ACA-CNPEM/evolver-harware/README.md

# evolver-harware
Hardware made for the "eVOLVER versão CNPEM"
