ACA-CNPEM/evolver-harware/ADC/adc-bom.ods

Comment | Designator | Footprint | JLCPCB Part #（optional）
.1uF | C1 C10 C11 C12 C13 C14 C15 C16 C17 C18 C19 C2 C20 C21 C22 C23 C24 C3 C4 C5 C6 C7 C8 C9 | Capacitors_SMD:C_0402 | C527001 | YAGEO CC0402JRX7R6BB104
74HC4067 | IC1 | ADC:74HC_HTC4067 | -
CONNX25 | P1 P2 | mods:25_pin_10in | -
10k | R1 R12 R13 R16 R17 R20 R21 R24 R25 R28 R29 R32 R33 R36 R37 R4 R40 R41 R44 R45 R48 R49 R5 R52 R53 R56 R57 R60 R61 R64 R65 R8 R9 | Resistors_SMD:R_0402 | C25744 | UNI-ROYAL(Uniroyal Elec) 0402WGF1002TCE
1 M | R10 R14 R18 R2 R22 R26 R30 R34 R38 R42 R46 R50 R54 R58 R6 R62 | Resistors_SMD:R_0402 | C26083 | UNI-ROYAL(Uniroyal Elec) 0402WGF1004TCE
OMIT | R11 R15 R19 R23 R27 R3 R31 R35 R39 R43 R47 R51 R55 R59 R63 R7 | Resistors_SMD:R_0402
TLV1117LV33DCYR | U1 | ADC:TLV1117 | C15578 | Texas Instruments TLV1117LV33DCYR
MCP6001 | U2 | ADC:MCP6001 | C116490 | Microchip Tech MCP6001T-I/OT
MCP6004 | U3 U4 U5 U6 | ADC:MCP6004 | C50282 | Microchip Tech MCP6004T-I/ST
