ACA-CNPEM/evolver-harware/Auxiliary/aux-bom.xlsx

Comment | Designator | Footprint | JLCPCB Part #（optional）
10 uF | C1 | mods:FK18X5R0J105K
10uF | C2 C3 | mods:FK18X5R0J105K
Heatsink | HS1 | mods:CSM222-30AE
CONN_01X02 | J1 | mods:OSTYK51102030
DNP | J2 | mods:OSTYK51102030
DNP | J3 | mods:2.1mm_DC_Jack
FAN | J4 | mods:OSTYK51102030
CONN_02X25 | M1 M2 M3 | mods:50_pin_10in
CONN_02X09 | M4 | mods:2x_9_pin_10in
MountingHole | MH1 MH2 MH3 MH4 MH5 MH6 | mods:mh_632
CONN_02X08 | P1 P2 P3 P4 P5 P6 | mods:2x8_conn_10in
RJ14 | P7 P8 | mods:RJ14
CONN_01X10 | GND_M1 GND_M2 GND_M3 PWR_M1 PWR_M2 PWR_M3 | mods:10pin_tenth_in
50k | R1 | mods:R_0.25W
10k | R2 | mods:R_0.25W
CONN_02X12 | U1 | mods:24_pin_10in
MC7805 | U2 | mods:TO-220
