ACA-CNPEM/evolver-harware/CMB/cmb-bom.ods

Comment | Designator | Footprint | JLCPCB Part #（optional）
CONN_02X08 | P1 | mods:2x8_pin_10in | -
CONN_01X04 | P2 | mods:4_ScrewTerm | C918122 | DIBO DB125-2.54-4P-GN-S
DNP (Thermistor) | P5 | mods:Thermistor | - | 103 jt-025 / semitec
IR LED | P6 | mods:screw_terminal | C557685 | Ningbo Xinlaiya Elec. XY308-2.54-2P
IR Detector | P7 | mods:screw_terminal | C557685 | Ningbo Xinlaiya Elec. XY308-2.54-2P
Spare B | P8 | mods:screw_terminal | C557685 | Ningbo Xinlaiya Elec. XY308-2.54-2P
Spare A | P9 | mods:screw_terminal | C557685 | Ningbo Xinlaiya Elec. XY308-2.54-2P
82 | R1 R3 R4 R7 | mods:Through_hole_R | C265588 | Thunder Component MELF-MFR02041/4WS82ΩFT50
Heater 1 | R5 | mods:Heater | - | Mp915-20.0-1% / Caddock
Heater 2 | R6 | mods:Heater | - | Mp915-20.0-1% / Caddock
