ACA-CNPEM/evolver-harware/CMB/cmb-bom.xlsx

Comment | Designator | Footprint | JLCPCB Part #（optional）
CONN_02X08 | P1 | mods:2x8_pin_10in | C16133
CONN_01X04 | P2 | mods:4_ScrewTerm | C22809
DNP (Thermistor) | P5 | mods:Thermistor | C136744
IR LED | P6 | mods:screw_terminal | C27438
IR Detector | P7 | mods:screw_terminal | C110153
Spare B | P8 | mods:screw_terminal | C33901
Spare A | P9 | mods:screw_terminal | C114097
82 | R1 R3 R4 R7 | mods:Through_hole_R
Heater 1 | R5 | mods:Heater
Heater 2 | R6 | mods:Heater
