ACA-CNPEM/evolver-harware/CMB/SmartSleeve_Parts.xlsx

Description | Part # | Vendor | Purpose
Heating Resistors | 684-MP915-20 | Mouser | Turns current into heat for temperature control.
Thermistor | 954-103JT-025 | Mouser | Resistor that changes value based on temperature
IR LED | 475-2943-ND | Digikey | Optical density measurements.
IR Photodiode | 160-1987-ND | Digikey | Optical density measurements.
12V Computer Fan | Q619-ND | Digikey | Computer Fan to Mount Magnets
