ACA-CNPEM/evolver-harware/Motherboard/mb-bom.xlsx

Comment | Designator | Footprint
1uF | C1 C10 C11 C12 C13 C14 C19 C2 C20 C3 C4 C5 C6 C7 C8 C9 | mods:FK18X5R0J105K
10 uF | C15 C16 C17 C18 | mods:FK18X5R0J105K
CONN_01X10 | GND_M1 GND_M2 GND_M3 GND_M4 GND_M5 GND_M6 GND_M7 GND_M8 PWR_M1 PWR_M2 PWR_M3 PWR_M4 PWR_M5 PWR_M6 PWR_M7 PWR_M8 | mods:10_pin_10in
SCREW_TERM | J1 | mods:OSTYK51104030
USB_A | J3 J6 | mods:USB-A
CONN_02X03 | J4 | mods:2x3_pin_10in
DNP | J2 J5 | mods:USB-A_vert
RJ14 | J7 | mods:609-1064-ND
RJ14 | J8 | mods:609-5080-ND
JUMPER3 | JP1 JP2 JP3 JP4 JP5 JP6 JP7 JP8 | mods:Pin_Header_Straight_1x03_Pitch5.08mm
CONN_02X25 | M1 M2 M3 M4 M5 M6 M7 M8 | mods:50_pin_10in
CONN_02X09 | M9 | mods:RS485
MountingHole | MH1 MH10 MH11 MH12 MH13 MH14 MH15 MH16 MH2 MH3 MH4 MH5 MH6 MH7 MH8 MH9 | mods:mh_632
CONN_02X08 | P1 P10 P11 P12 P13 P14 P15 P16 P2 P3 P4 P5 P6 P7 P8 P9 | mods:2x8_pin_10in
CONN_01X02 | P31 | mods:2_pin_10in
Jumper_Receptacle | P38 P39 P40 P41 P42 P43 P44 P45 P46 P47 P48 P49 P50 P51 P52 P53 P54 P55 P56 P57 P58 P59 P60 P61
20k | R1 | mods:R_200mil
10k | R2 R3 R4 R5 | mods:R_200mil
9_R_01X10 | RP1 RP10 RP11 RP12 RP13 RP14 RP15 RP16 RP2 RP3 RP4 RP5 RP6 RP7 RP8 RP9 | mods:10_pin_10in
via_stitch | TP1 TP10 TP11 TP12 TP13 TP14 TP15 TP16 TP17 TP18 TP19 TP2 TP20 TP21 TP22 TP23 TP24 TP3 TP4 TP5 TP6 TP7 TP8 TP9 | mods:stitch_via
CONN_02X12 | U1 U2 U3 U4 | mods:24_pin_10in
