ACA-CNPEM/evolver-harware/Pi-HAT/pi-hat-bom.ods

Comment | Designator | Footprint | JLCPCB Part #
1uF | C1 C2 C3 | project_footprints:C_0805_HS | C89259 | FH (Guangdong Fenghua Adva
LED | D1 D2 | project_footprints:LED_0603 | C497926 | HONGLITRONIC(Hongli Zhihui
raspberrypi_hat:OX40HAT | J1 | project_footprints:Connector_PinSocket_2.54mm | BCEF2 (Filipeflop) | https://www.makerhero.com/produto/barra-de-pinos-2x20-macho-femea/
Header_10Pin | J2 | project_footprints:10Pin_Header | -
Header_8Pin | J3 J4 J5 | project_footprints:8Pin_Header | -
RJ14 | J6 | project_footprints:609-5080-ND
2Screw_Term | J7 | project_footprints:277-1667-ND | C784572 | DEGSON DG125-5.0-02P-14-00A(H)
2N7002 | Q3 Q4 | project_footprints:2N7002 | C8545 | Jiangsu Changjing Electronics
BSS123 | Q5 | project_footprints:2N7002 | C79015 | Jiangsu Changjing Electronic
510 | R1 R2 | project_footprints:R_805_HS | C228886 | YAGEO AC0805FR-07510RL
DNP | R3 R6 | project_footprints:R_805_HS | C17414 | UNI-ROYAL(Uniroyal Elec) 080
10k | R10 R12 R4 R5 | project_footprints:R_805_HS | C17414 | UNI-ROYAL(Uniroyal Elec) 080
MAX3485 | U1 | project_footprints:SO-8
