ACA-CNPEM/evolver-harware/Pi-HAT/pi-hat-bom.xlsx

Comment | Designator | Footprint | JLCPCB Part #（optional）
1uF | C1 C2 C3 | project_footprints:C_0805_HS
LED | D1 D2 | project_footprints:LED_0603
raspberrypi_hat:OX40HAT | J1 | project_footprints:Connector_PinSocket_2.54mm
Header_10Pin | J2 | project_footprints:10Pin_Header
Header_8Pin | J3 J4 J5 | project_footprints:8Pin_Header
RJ14 | J6 | project_footprints:609-5080-ND
2Screw_Term | J7 | project_footprints:277-1667-ND
2N7002 | Q3 Q4 | project_footprints:2N7002
BSS123 | Q5 | project_footprints:2N7002
510 | R1 R2 | project_footprints:R_805_HS
DNP | R3 R6 | project_footprints:R_805_HS
10k | R10 R12 R4 R5 | project_footprints:R_805_HS
MAX3485 | U1 | project_footprints:SO-8
