ACA-CNPEM/evolver-harware/RS485/rs485-bom.xlsx

Comment | Designator | Footprint | JLCPCB Part #（optional）
.1uF | C1 C2 C3 | mods:C_0402
10nF | C4 | mods:C_0402
1nF | C5 | mods:C_0402
100pF | C6 | mods:C_0402
10pF | C7 | mods:C_0402
CONN_01X09 | P1 P2 | mods:9_pin_10in
10k | R1 R2 R3 R4 | mods:R_0402
SP3485CN | U1 U2 U4 U5 | mods:SO-8
TLV1117LV33DCYR | U3 | mods:TLV1117LV33DCYR
