ACA-CNPEM/evolver-harware/PWM/pwm-bom.xlsx

Comment | Designator | Footprint | JLCPCB Part #（optional）
0.1uF | C1 C10 C2 C5 C6 C7 C8 C9 | mods:C_0402
1uF | C3 C4 | mods:C_0402
ZHCS506TA | D1 D10 D11 D12 D13 D14 D15 D16 D2 D3 D4 D5 D6 D7 D8 D9 | mods:ZHCS506TA
CONN_01X25_1 | P1 P2 | mods:25_pin_10in
CONN_01X10 | P3 P4 | mods:10pin_tenth_in
AO3422 | Q1 Q10 Q11 Q12 Q13 Q14 Q15 Q16 Q2 Q3 Q4 Q5 Q6 Q7 Q8 Q9 | mods:AO3422
10K | R1 R10 R11 R12 R13 R14 R15 R16 R2 R3 R4 R5 R6 R7 R8 R9 R18 | mods:R_0402
2.2k | R17 | mods:R_0402
TLV1117LV33DCYR | U1 | mods:TLV1117LV33DCYR
TLC5940PWP | U2 | mods:TLC5940PWP
