ACA-CNPEM/evolver-harware/RS485/rs485-bom.ods

Comment | Designator | Footprint | JLCPCB Part #（optional）
.1uF | C1 C2 C3 | mods:C_0402 | C110251 | FH (Guangdong Fenghua Advanced Tech) 0402B104K500NT
10nF | C4 | mods:C_0402 | C1524 | FH (Guangdong Fenghua Advanced Tech) 0402B103K500NT
1nF | C5 | mods:C_0402 | C335530 | Walsin Tech Corp 0402B102K250CT
100pF | C6 | mods:C_0402 | C1546 | FH (Guangdong Fenghua Advanced Tech) 0402CG101J500NT
10pF | C7 | mods:C_0402 | C295953 | Walsin Tech Corp 0402N100D500CT
CONN_01X09 | P1 P2 | mods:9_pin_10in | -
10k | R1 R2 R3 R4 | mods:R_0402 | C269674 | TyoHM RMC040210KFN
SP3485CN | U1 U2 U4 U5 | mods:SO-8 | -
TLV1117LV33DCYR | U3 | mods:TLV1117LV33DCYR | C15578 | Texas Instruments TLV1117LV33DCYR
