ACA-CNPEM/evolver-harware/Schematics PDF/Motherboard.pdf

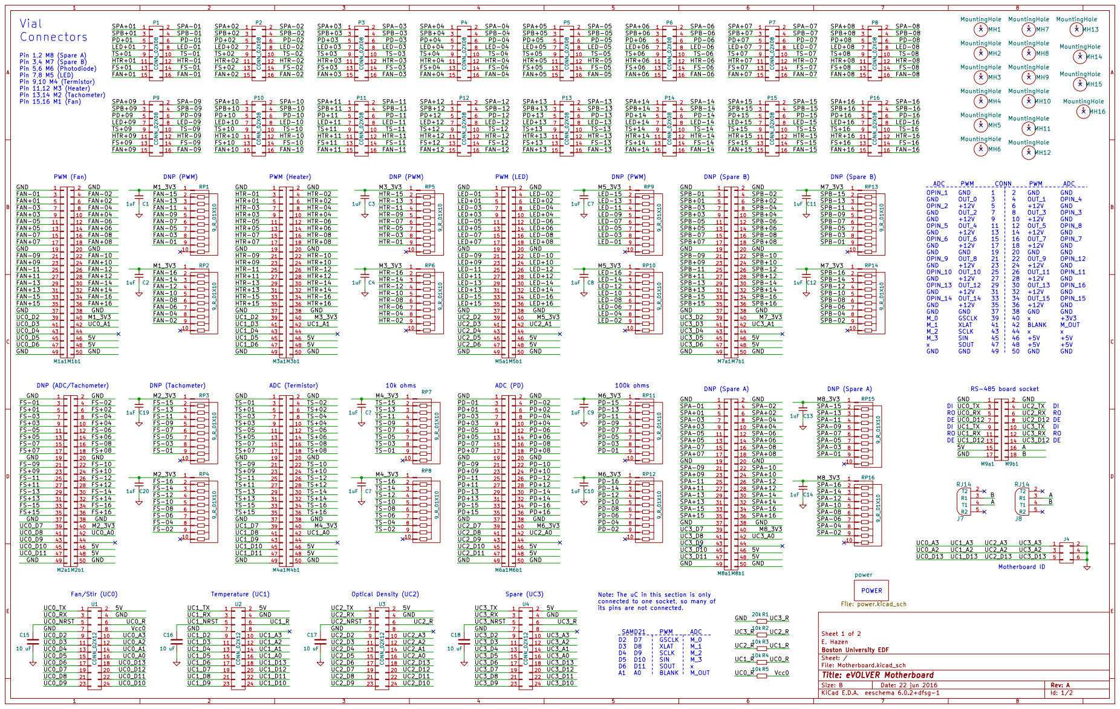
[picture p1: page 1]

FS+02 FAN+02 SPA+02 PD+02 SPB+02

SPA-07
LED+08 FS+16 PD+16 FAN+16 SPB+16

LED+01
TS+02 HTR+02 FS-09 FAN-09 PD+09

LED-02 FAN-02 HTR-02 FS-02

LED+15 FAN-05 HTR-05 FS-05

Pin 1,2 M8 (Spare A)
SPA-09 FAN-01 FS+01 HTR+01 FAN+01 FAN+09 GND
Pin 3,4 M7 (Spare B)
Pin 5,6 M6 (Photodiode)
Pin 7,8 M5 (LED)
Pin 9,10 M4 (Termistor)
Pin 11,12 M3 (Heater)
Pin 13,14 M2 (Tachometer)

FS+04 HTR-02 HTR+02 GND

LED+13 FAN+05 HTR-13 FAN-04 GND

LED+10 SPB-09
LED-09 HTR-09 PD-09 TS-09

LED+11 SPA+11 PD+11 SPB+11

LED-13 SPA-13 PD-13 SPB-13

FAN+09 FAN-01 FAN+01 FAN-15 FAN+11 FAN-13 FAN+13 FAN+05 FAN+07 GND

HTR+16 HTR-16 HTR+14 HTR-06 HTR+06 HTR-04 FS-16

UC1_D5 HTR-15 HTR+15 HTR+13 GND

Note: The uC in this section is only
connected to one socket, so many of
its pins are not connected.

Id: 1/2 Title: eVOLVER Motherboard

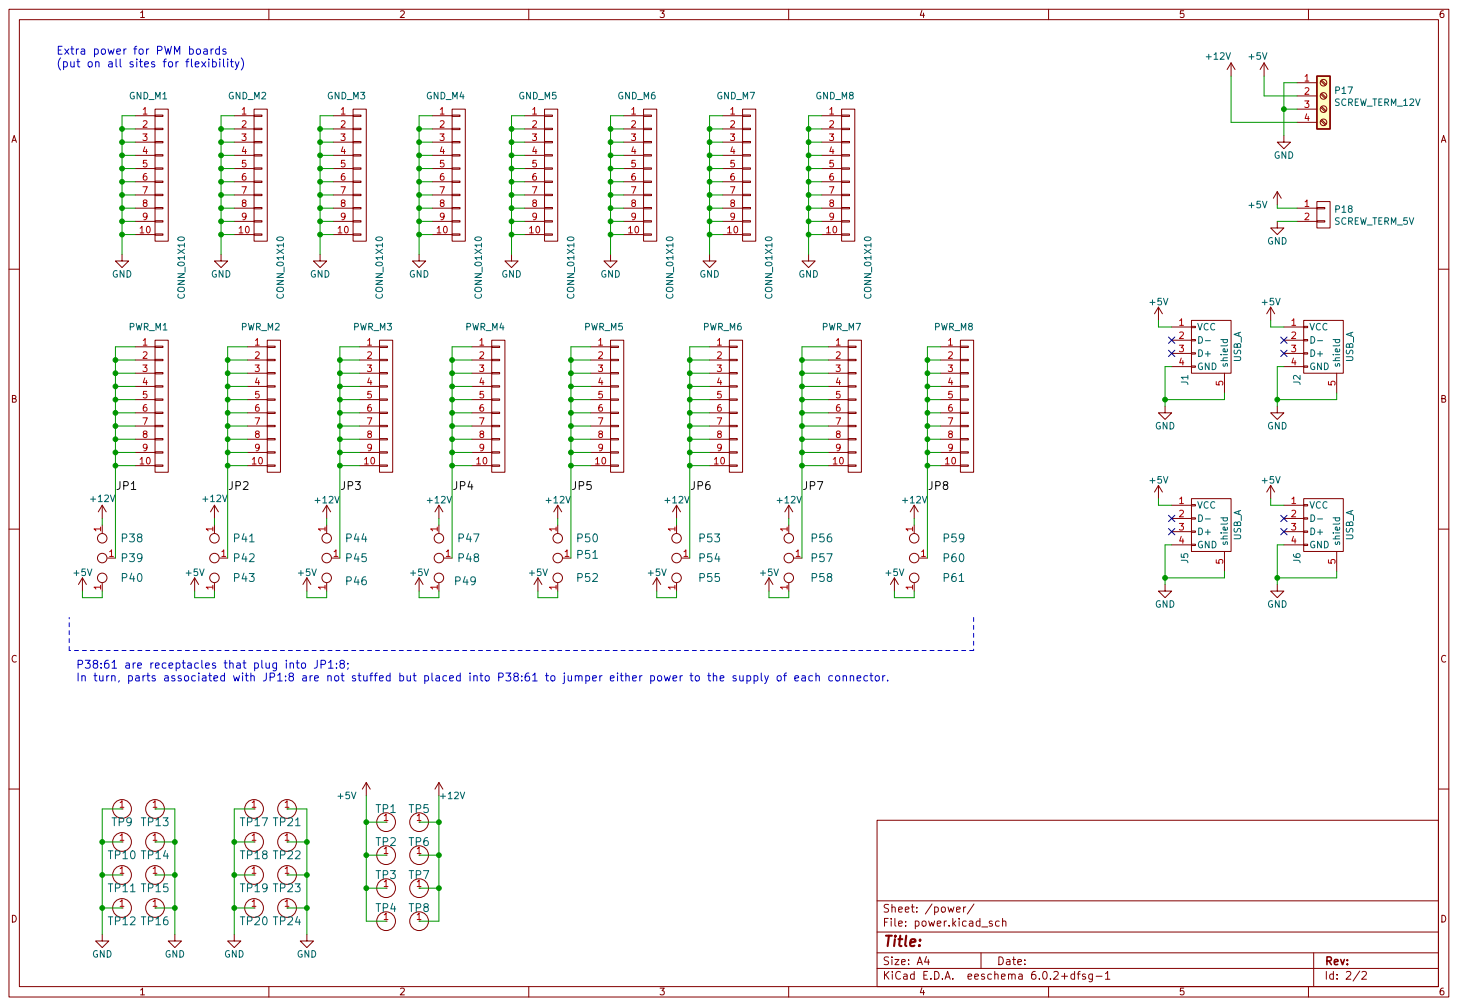
[picture p2: page 2]

P38:61 are receptacles that plug into JP1:8;
In turn, parts associated with JP1:8 are not stuffed but placed into P38:61 to jumper either power to the supply of each connector.
