ACA-CNPEM/evolver-harware/Schematics PDF/Auxiliary_Board.pdf

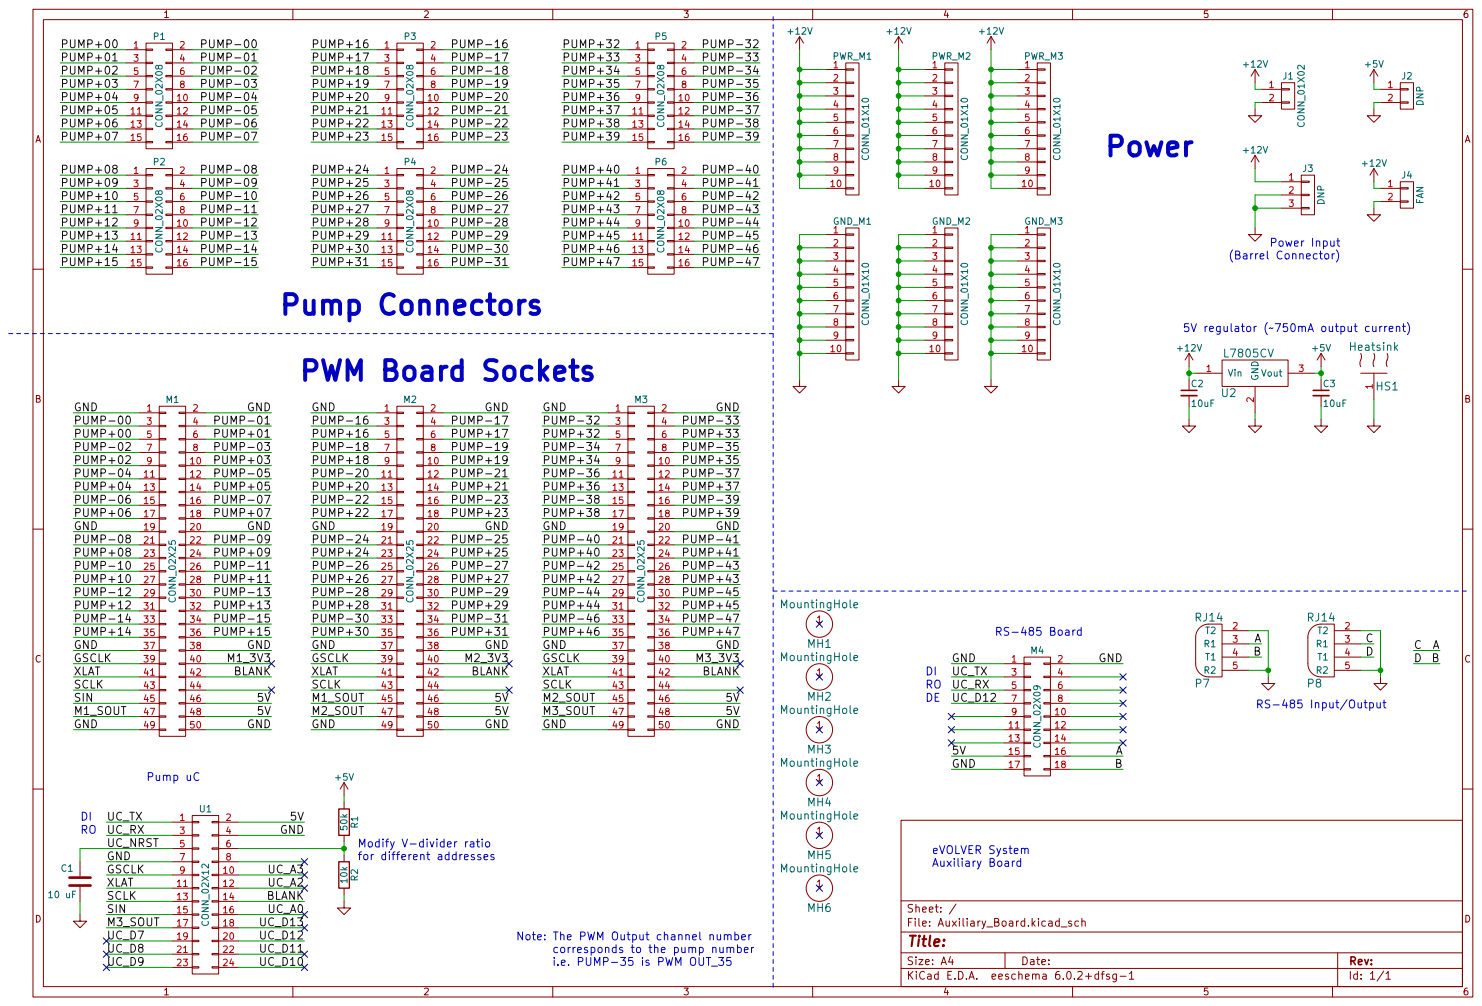
[picture p3: page 1]

PUMP-43 PUMP+17 PUMP-17 PUMP-19 UC_D9
PUMP-44 SCLK

PUMP-25 PUMP+25 PUMP-27 PUMP+23 GSCLK

PUMP+44 PUMP-44 PUMP+27 PUMP-29

for different addresses RO

corresponds to the pump number
i.e. PUMP-35 is PWM OUT_35
