ACA-CNPEM/evolver-harware/Schematics PDF/CMB.pdf

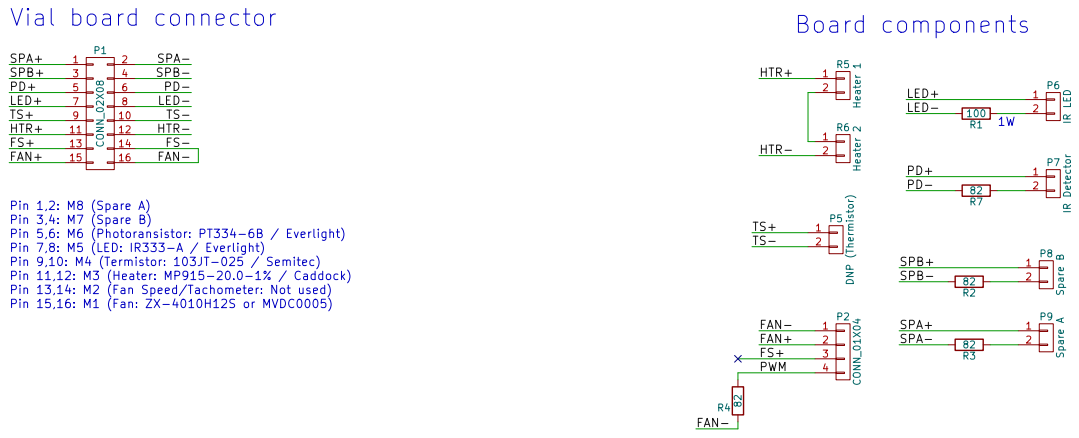
[picture p4: page 1]

LED+ TS+ PD+ Pin 11,12: M3 (Heater: MP915-20.0-1% / Caddock)

11 | 12
13 | 14

Pin 13,14: M2 (Fan Speed/Tachometer: Not used)
Pin 15,16: M1 (Fan: ZX-4010H12S or MVDC0005)
