ACA-CNPEM/evolver-harware/Schematics PDF/Pi-Hat.pdf

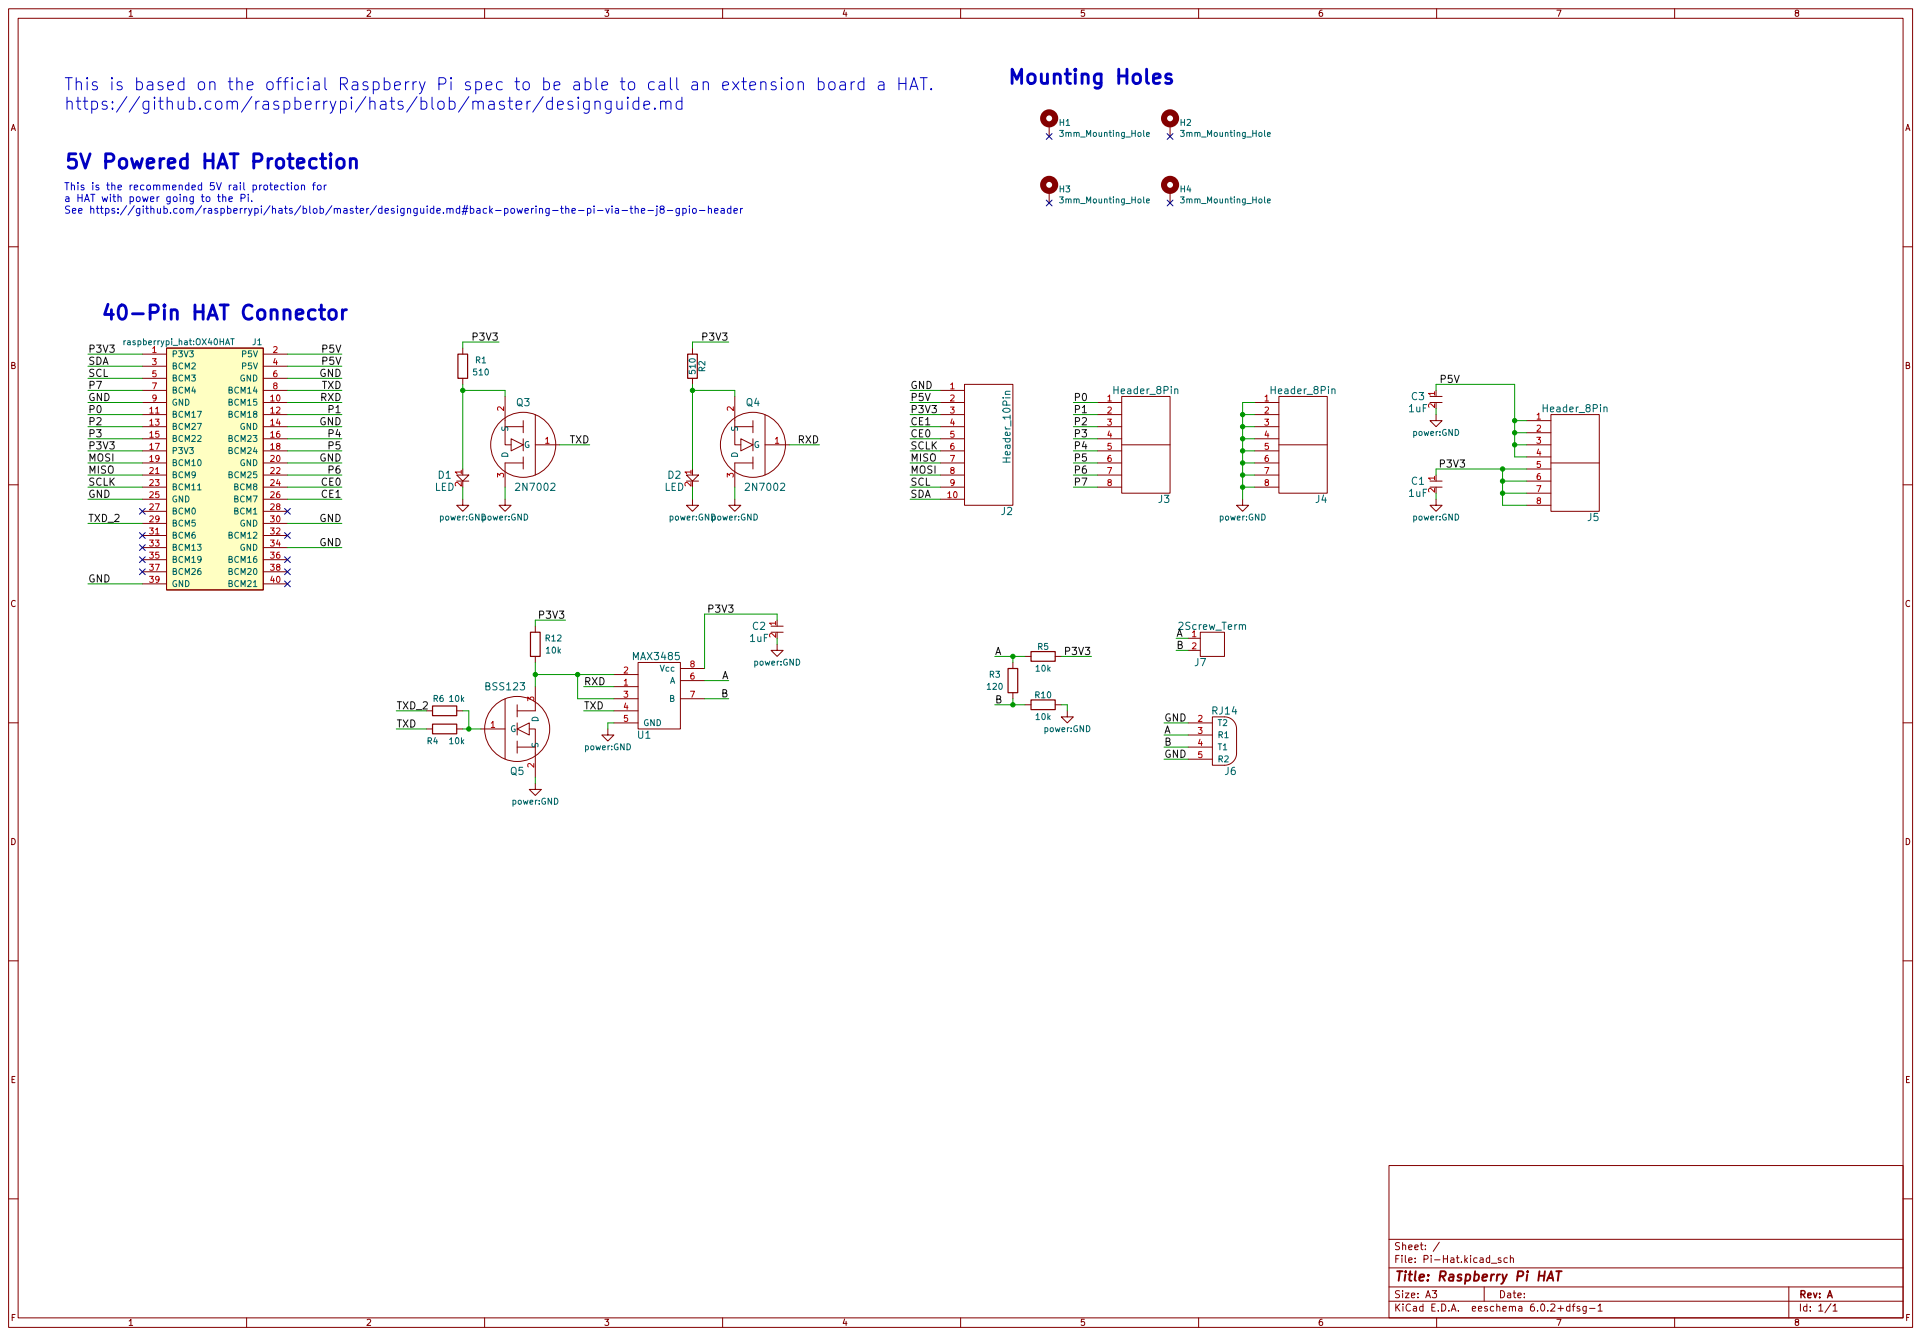
[picture p5: page 1]

This is based on the official Raspberry Pi spec to be able to call an extension board a HAT.
https://github.com/raspberrypi/hats/blob/master/designguide.md

This is the recommended 5V rail protection for
a HAT with power going to the Pi.
See https://github.com/raspberrypi/hats/blob/master/designguide.md#back-powering-the-pi-via-the-j8-gpio-header

File: Pi-Hat.kicad_sch Sheet: /
Id: 1/1 Title: Raspberry Pi HAT
