ACA-CNPEM/evolver-harware/Schematics PDF/RS485.pdf

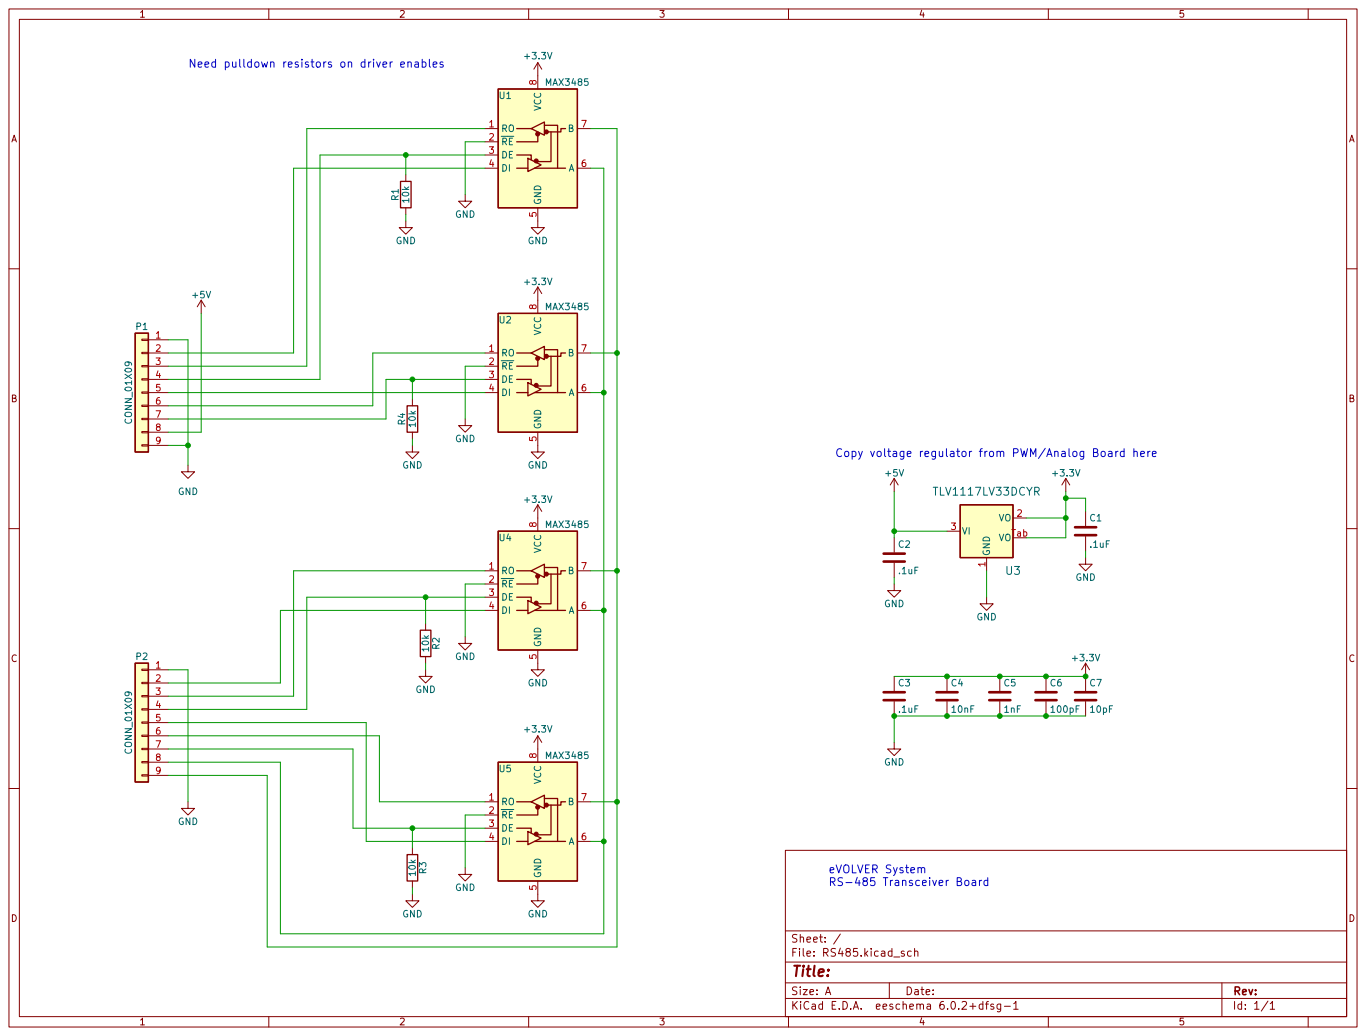
[picture p6: page 1]

Need pulldown resistors on driver enables

Copy voltage regulator from PWM/Analog Board here
