ACA-CNPEM/evolver-harware/Schematics PDF/ADC.pdf

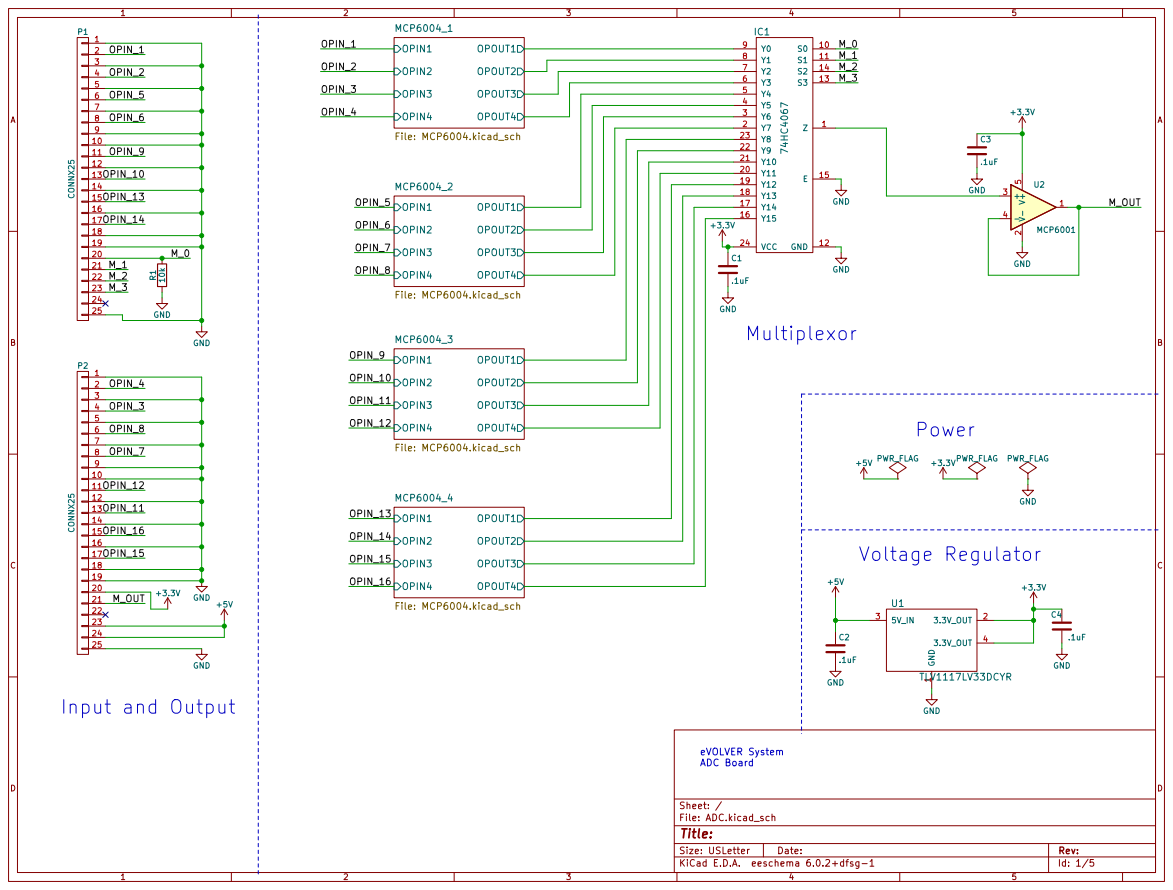
[picture p7: page 1]

253456789 P1 CONNX25

OPIN_5

OPIN_6

17 OPIN_14

10
OPIN_12 11

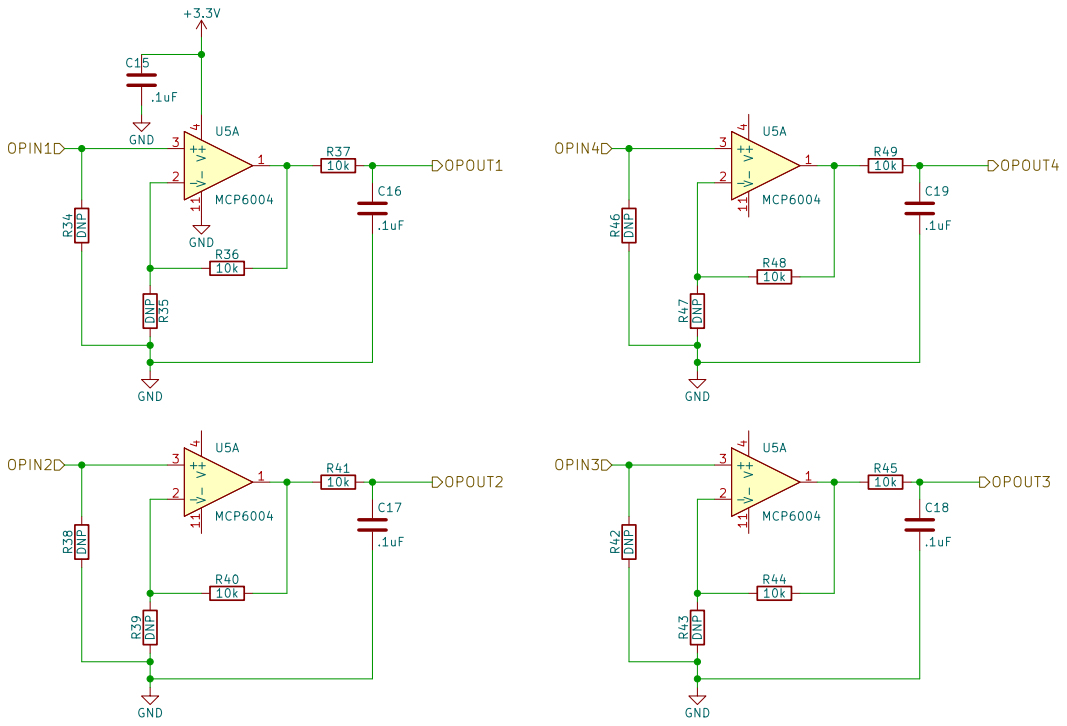
[picture p8: page 2]
