ACA-CNPEM/evolver-harware/Schematics PDF/PWM.pdf

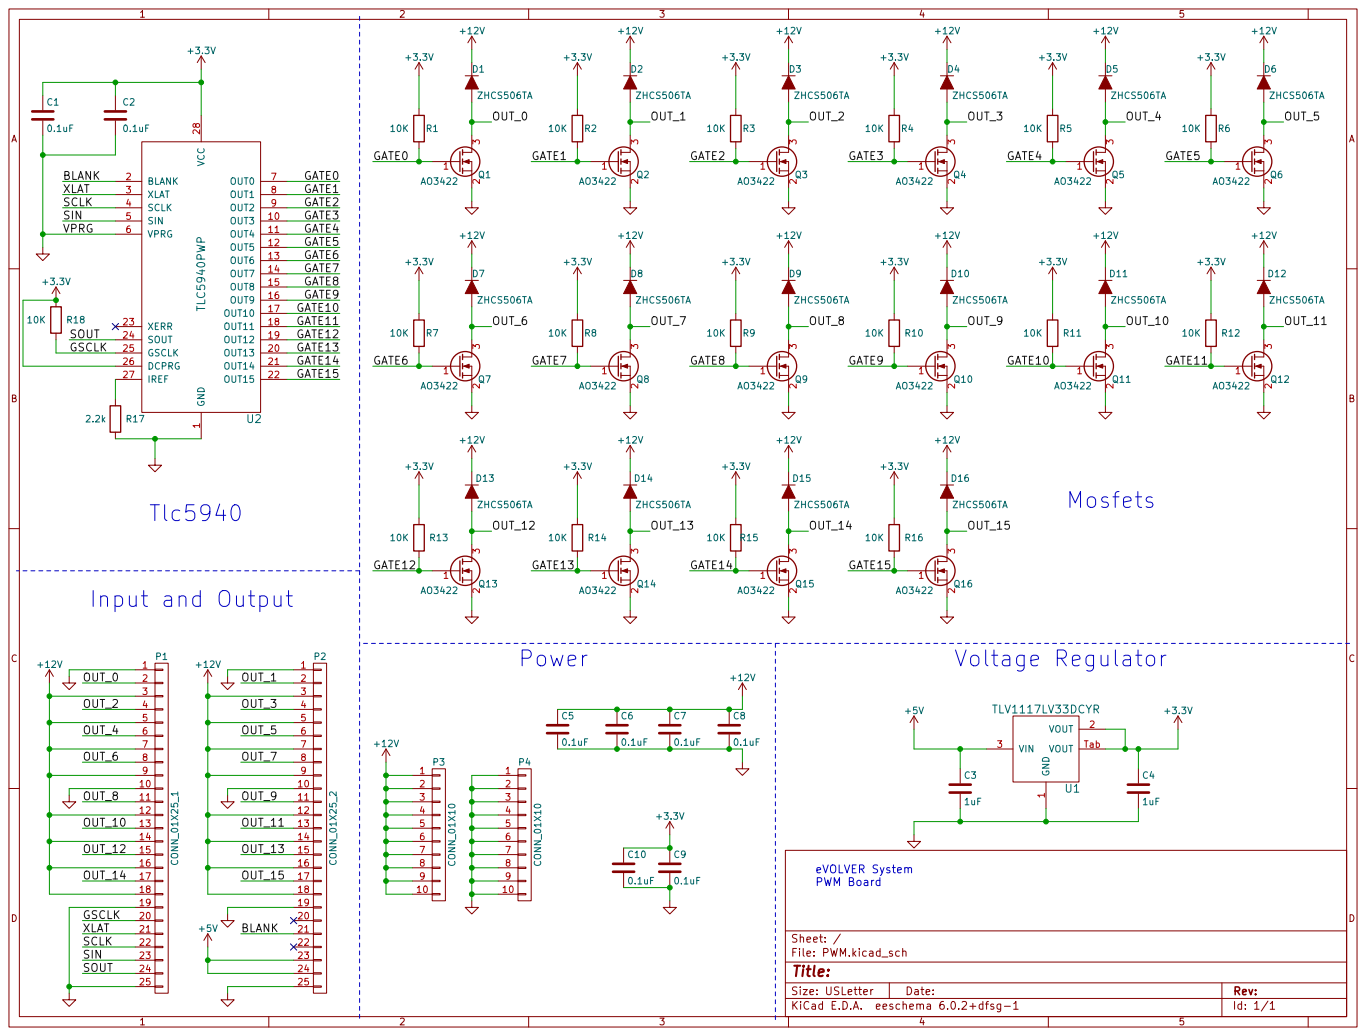
[picture p9: page 1]

1 OUT3 10 OUT4 11 OUT5 12 OUT6 13 OUT7 14 OUT8 15 OUT9 16 OUT10 17 OUT11 18 OUT12 19 BLANK 2 OUT13 20 OUT14 21 OUT15 22 XERR 23 SOUT 24 GSCLK 25 DCPRG 26

1 VOUT 2 VIN 3 VOUT Tab U1 TLV1117LV33DCYR

GSCLK | 20 | 20
