ACA-CNPEM/evolver-harware/(list of files, drawings)

Other design files:
Auxiliary/Fabricação/Auxiliary.dsn
