ACA-CNPEM/evolver-harware/ADC/Projeto/ADC.kicad_sch

## KiCad design ADC/Projeto/ADC.kicad_sch (2023-03-21)

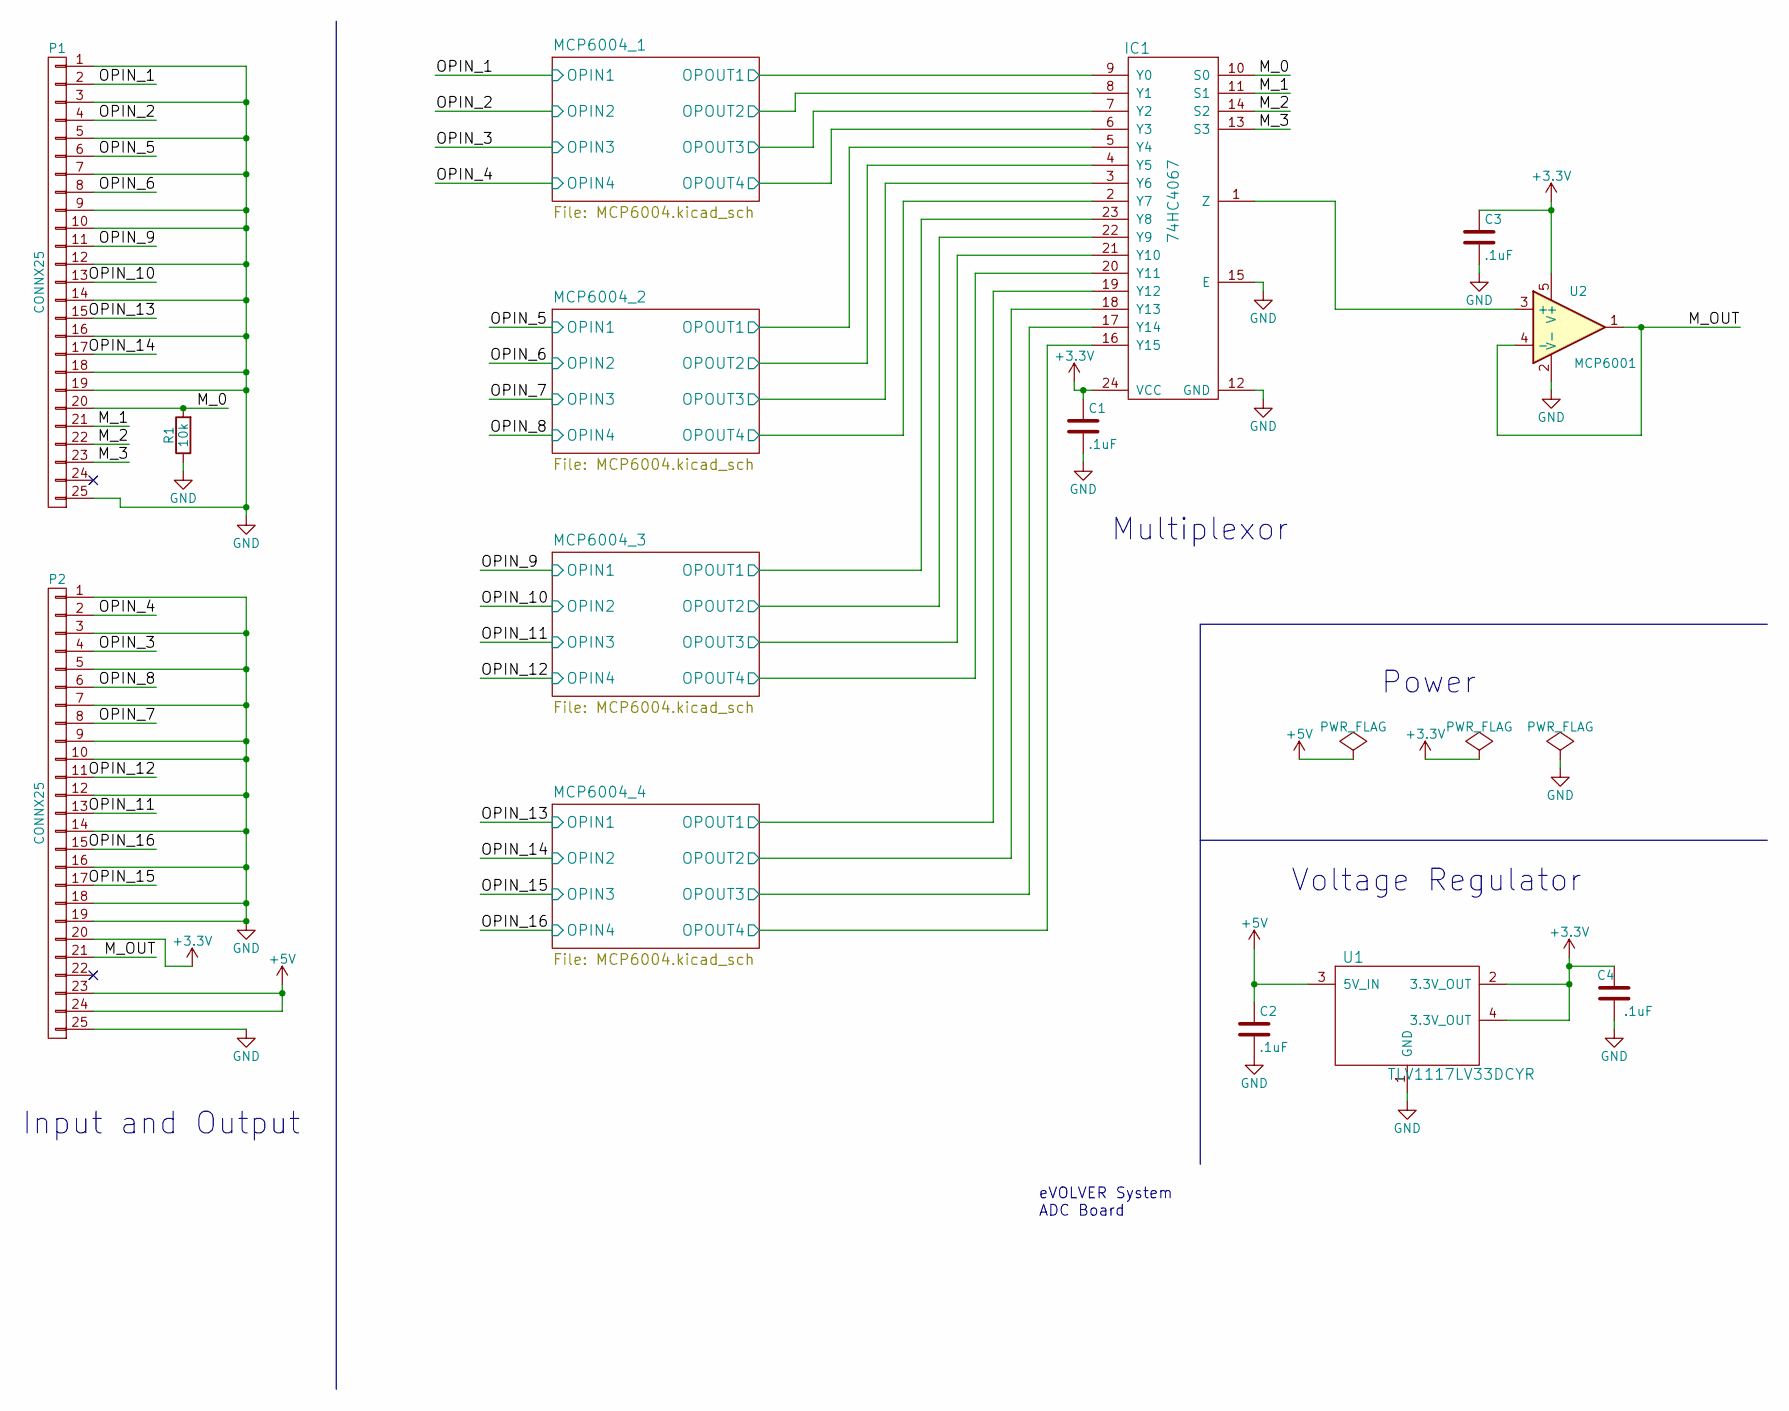
[picture p10: schematic ADC.kicad_sch]

Parts:
C1, C2, C3, C4: .1uF; C_0402
IC1: 74HC4067; 74HC_HTC4067
P1, P2: CONNX25; 25_pin_10in
R1: 10k; R_0402
U1: TLV1117LV33DCYR; TLV1117
U2: MCP6001

Connections:
+3.3V: C1.1, C3.1, C4.1, IC1.24 (VCC), P2.20, U1.2 (3.3V_OUT), U1.4 (3.3V_OUT), U2.5 (V+)
+5V: C2.1, P2.23, P2.24, U1.3 (5V_IN)
GND: C1.2, C2.2, C3.2, C4.2, IC1.12 (GND), IC1.15 (E), P1.1, P1.3, P1.5, P1.7, P1.9, P1.10, P1.12, P1.14, P1.16, P1.18, P1.19, P1.25, P2.1, P2.3, P2.5, P2.7, P2.9, P2.10, P2.12, P2.14, P2.16, P2.18, P2.19, P2.25, R1.1, U1.1 (GND), U2.2 (V-)
M_0: IC1.10 (S0), P1.20, R1.2
M_1: IC1.11 (S1), P1.21
M_2: IC1.14 (S2), P1.22
M_3: IC1.13 (S3), P1.23
M_OUT: P2.21, U2.1, U2.4 (-)
unnamed: IC1.1 (Z), U2.3 (+)
OPIN_1: P1.2
OPIN_2: P1.4
OPIN_3: P2.4
OPIN_4: P2.2
OPIN_5: P1.6
OPIN_6: P1.8
OPIN_7: P2.8
OPIN_8: P2.6
OPIN_9: P1.11
OPIN_10: P1.13
OPIN_11: P2.13
OPIN_12: P2.11
OPIN_13: P1.15
OPIN_14: P1.17
OPIN_15: P2.17
OPIN_16: P2.15
OPOUT1: IC1.5 (Y4), IC1.9 (Y0), IC1.19 (Y12), IC1.23 (Y8)
OPOUT2: IC1.4 (Y5), IC1.8 (Y1), IC1.18 (Y13), IC1.22 (Y9)
OPOUT3: IC1.3 (Y6), IC1.7 (Y2), IC1.17 (Y14), IC1.21 (Y10)
OPOUT4: IC1.2 (Y7), IC1.6 (Y3), IC1.16 (Y15), IC1.20 (Y11)

Notes on the sheet:
eVOLVER System ADC Board
Input and Output
Multiplexor
Voltage Regulator
Power
