ACA-CNPEM/evolver-harware/ADC/Projeto/MCP6004.kicad_sch

## KiCad design ADC/Projeto/MCP6004.kicad_sch (2023-03-21)

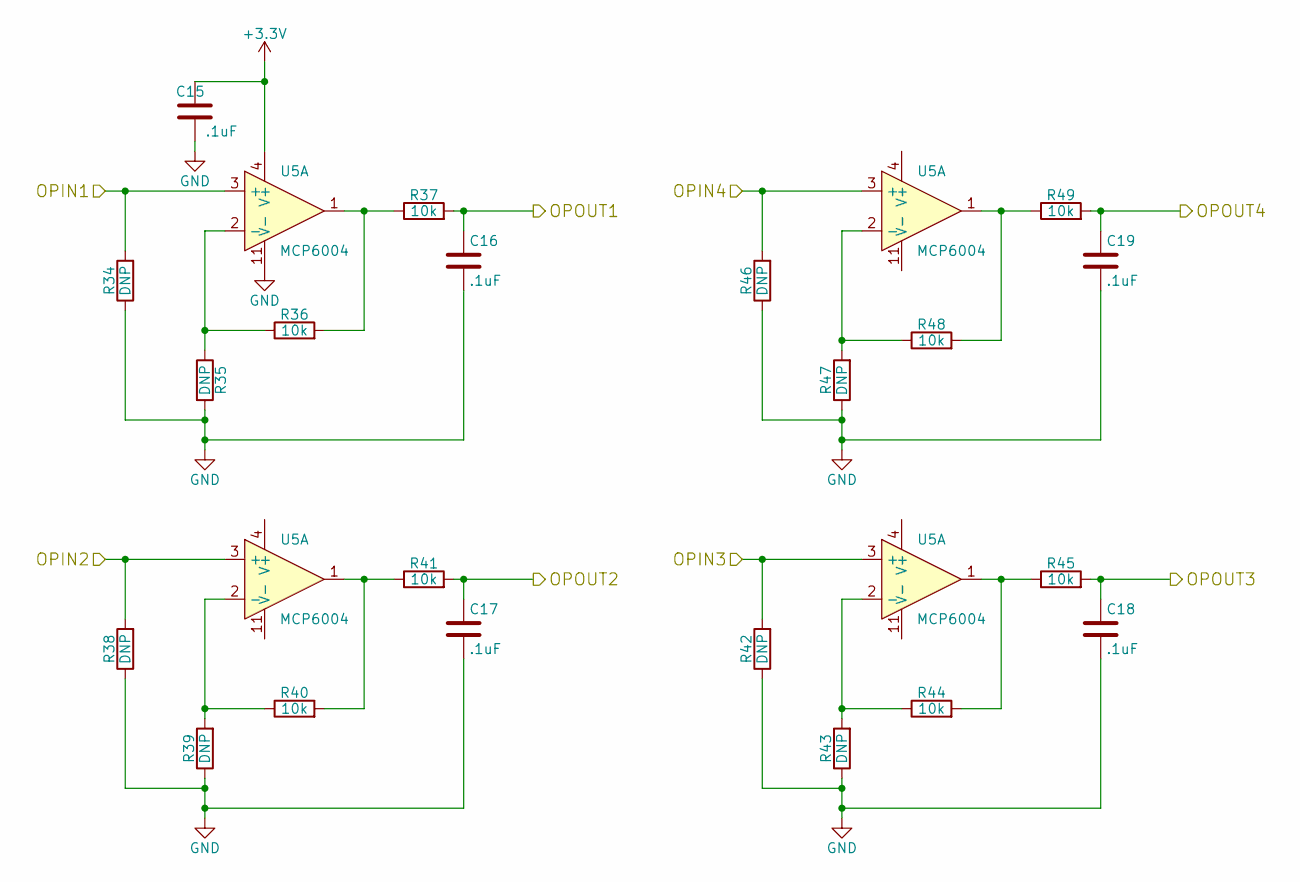
[picture p11: schematic MCP6004.kicad_sch]

Parts:
C15, C16, C17, C18, C19: .1uF; C_0402
R34, R35, R38, R39, R42, R43, R46, R47: DNP; R_0402
R36, R37, R40, R41, R44, R45, R48, R49: 10k; R_0402
U5: MCP6004

Connections:
+3.3V: C15.1, U5.4 (V+)
GND: C15.2, C16.2, C17.2, C18.2, C19.2, R34.1, R35.2, R38.1, R39.1, R42.1, R43.1, R46.1, R47.1, U5.11 (V-)
unnamed: R35.1, R36.1, U5.2 (-)
unnamed: R36.2, R37.1, U5.1
unnamed: R39.2, R40.1, U5.2 (-)
unnamed: R40.2, R41.1, U5.1
unnamed: R43.2, R44.1, U5.2 (-)
unnamed: R44.2, R45.1, U5.1
unnamed: R47.2, R48.1, U5.2 (-)
unnamed: R48.2, R49.1, U5.1
OPIN1: R34.2, U5.3 (+)
OPIN2: R38.2, U5.3 (+)
OPIN3: R42.2, U5.3 (+)
OPIN4: R46.2, U5.3 (+)
OPOUT1: C16.1, R37.2
OPOUT2: C17.1, R41.2
OPOUT3: C18.1, R45.2
OPOUT4: C19.1, R49.2
