ACA-CNPEM/evolver-harware/CMB/Projeto/CMB.kicad_sch

## KiCad design CMB/Projeto/CMB.kicad_sch (2023-03-21)

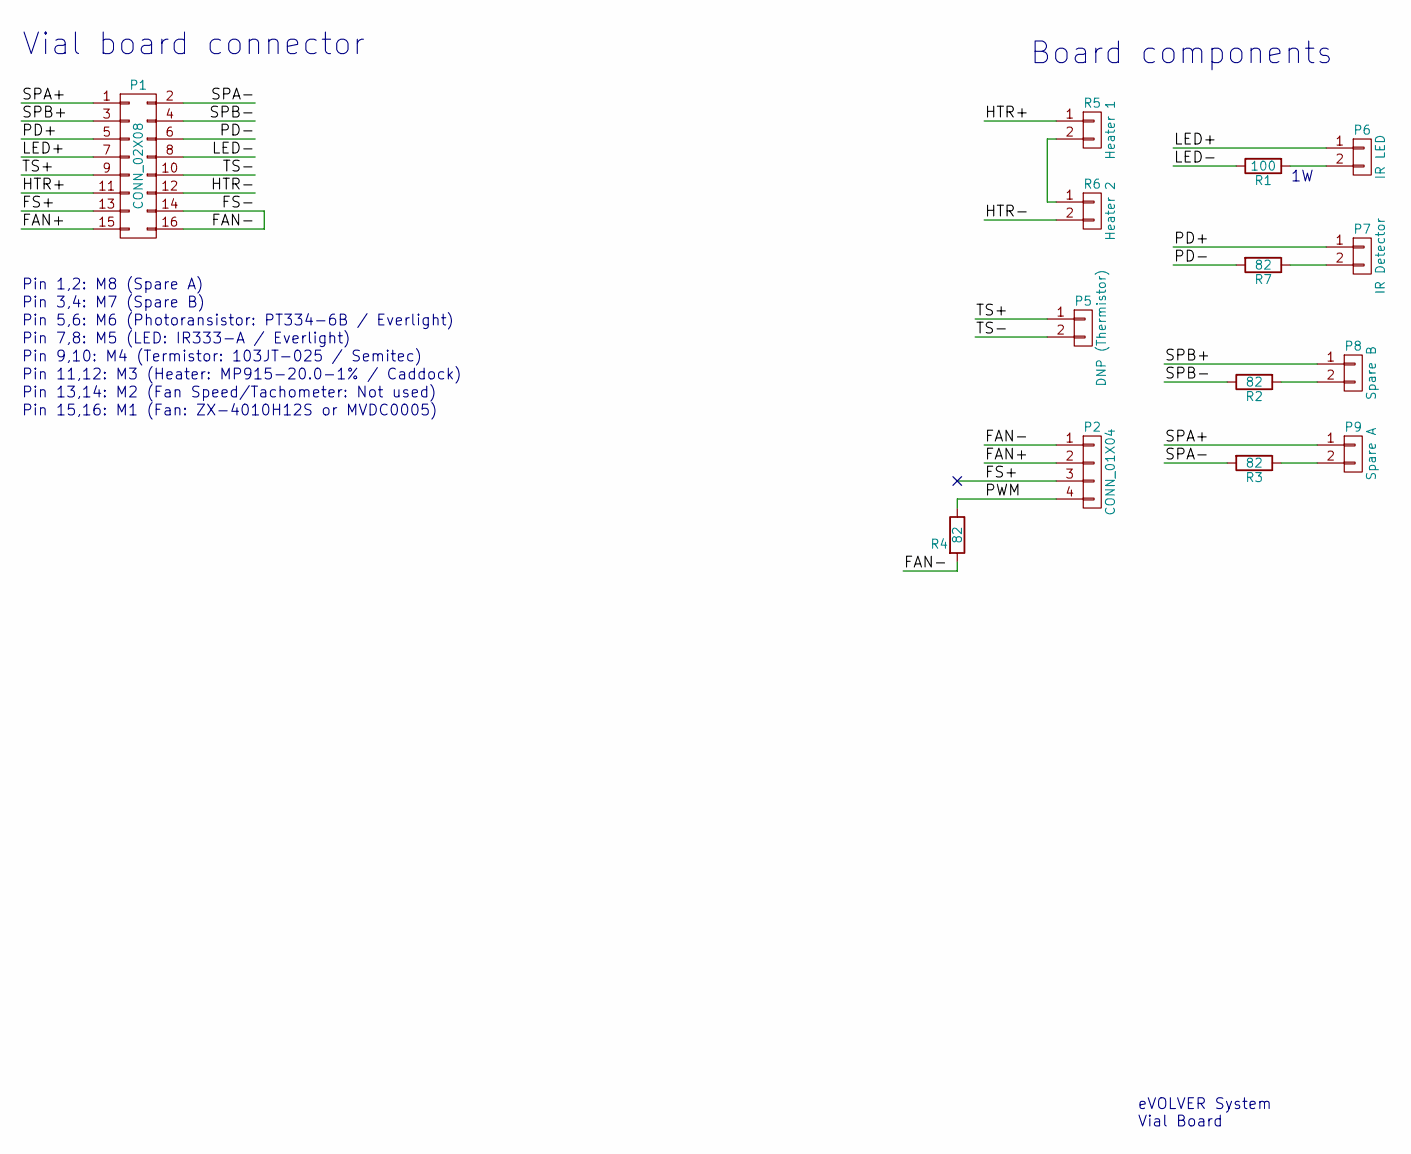
[picture p13: schematic CMB.kicad_sch]

Parts:
P1: CONN_02X08
P2: CONN_01X04; 4_ScrewTerm
P5: DNP (Thermistor); Thermistor
P6: IR LED; screw_terminal
P7: IR Detector; screw_terminal
P8: Spare B; screw_terminal
P9: Spare A; screw_terminal
R1: 100; R_0805_HandSoldering
R2, R3, R4, R7: 82; R_0805_HandSoldering
R5: Heater 1; Heater
R6: Heater 2; Heater

Connections:
FAN+: P1.15, P2.2
FAN-: P1.14, P1.16, P2.1, R4.2
FS+: P1.13, P2.3
HTR+: P1.11, R5.1
HTR-: P1.12, R6.2
LED+: P1.7, P6.1
LED-: P1.8, R1.1
unnamed: P6.2, R1.2
unnamed: P7.2, R7.1
unnamed: P8.2, R2.2
unnamed: P9.2, R3.1
unnamed: R5.2, R6.1
PD+: P1.5, P7.1
PD-: P1.6, R7.2
PWM: P2.4, R4.1
SPA+: P1.1, P9.1
SPA-: P1.2, R3.2
SPB+: P1.3, P8.1
SPB-: P1.4, R2.1
TS+: P1.9, P5.1
TS-: P1.10, P5.2

Notes on the sheet:
Pin 1,2: M8 (Spare A)
Vial board connector
Pin 11,12: M3 (Heater: MP915-20.0-1% / Caddock)
Pin 5,6: M6 (Photoransistor: PT334-6B / Everlight)
eVOLVER System Vial Board
Board components
Pin 13,14: M2 (Fan Speed/Tachometer: Not used)
Pin 15,16: M1 (Fan: ZX-4010H12S or MVDC0005)
Pin 9,10: M4 (Termistor: 103JT-025 / Semitec)
Pin 7,8: M5 (LED: IR333-A / Everlight)
Pin 3,4: M7 (Spare B)
