ACA-CNPEM/evolver-harware/PWM/Projeto/PWM.kicad_sch

## KiCad design PWM/Projeto/PWM.kicad_sch (2023-03-21)

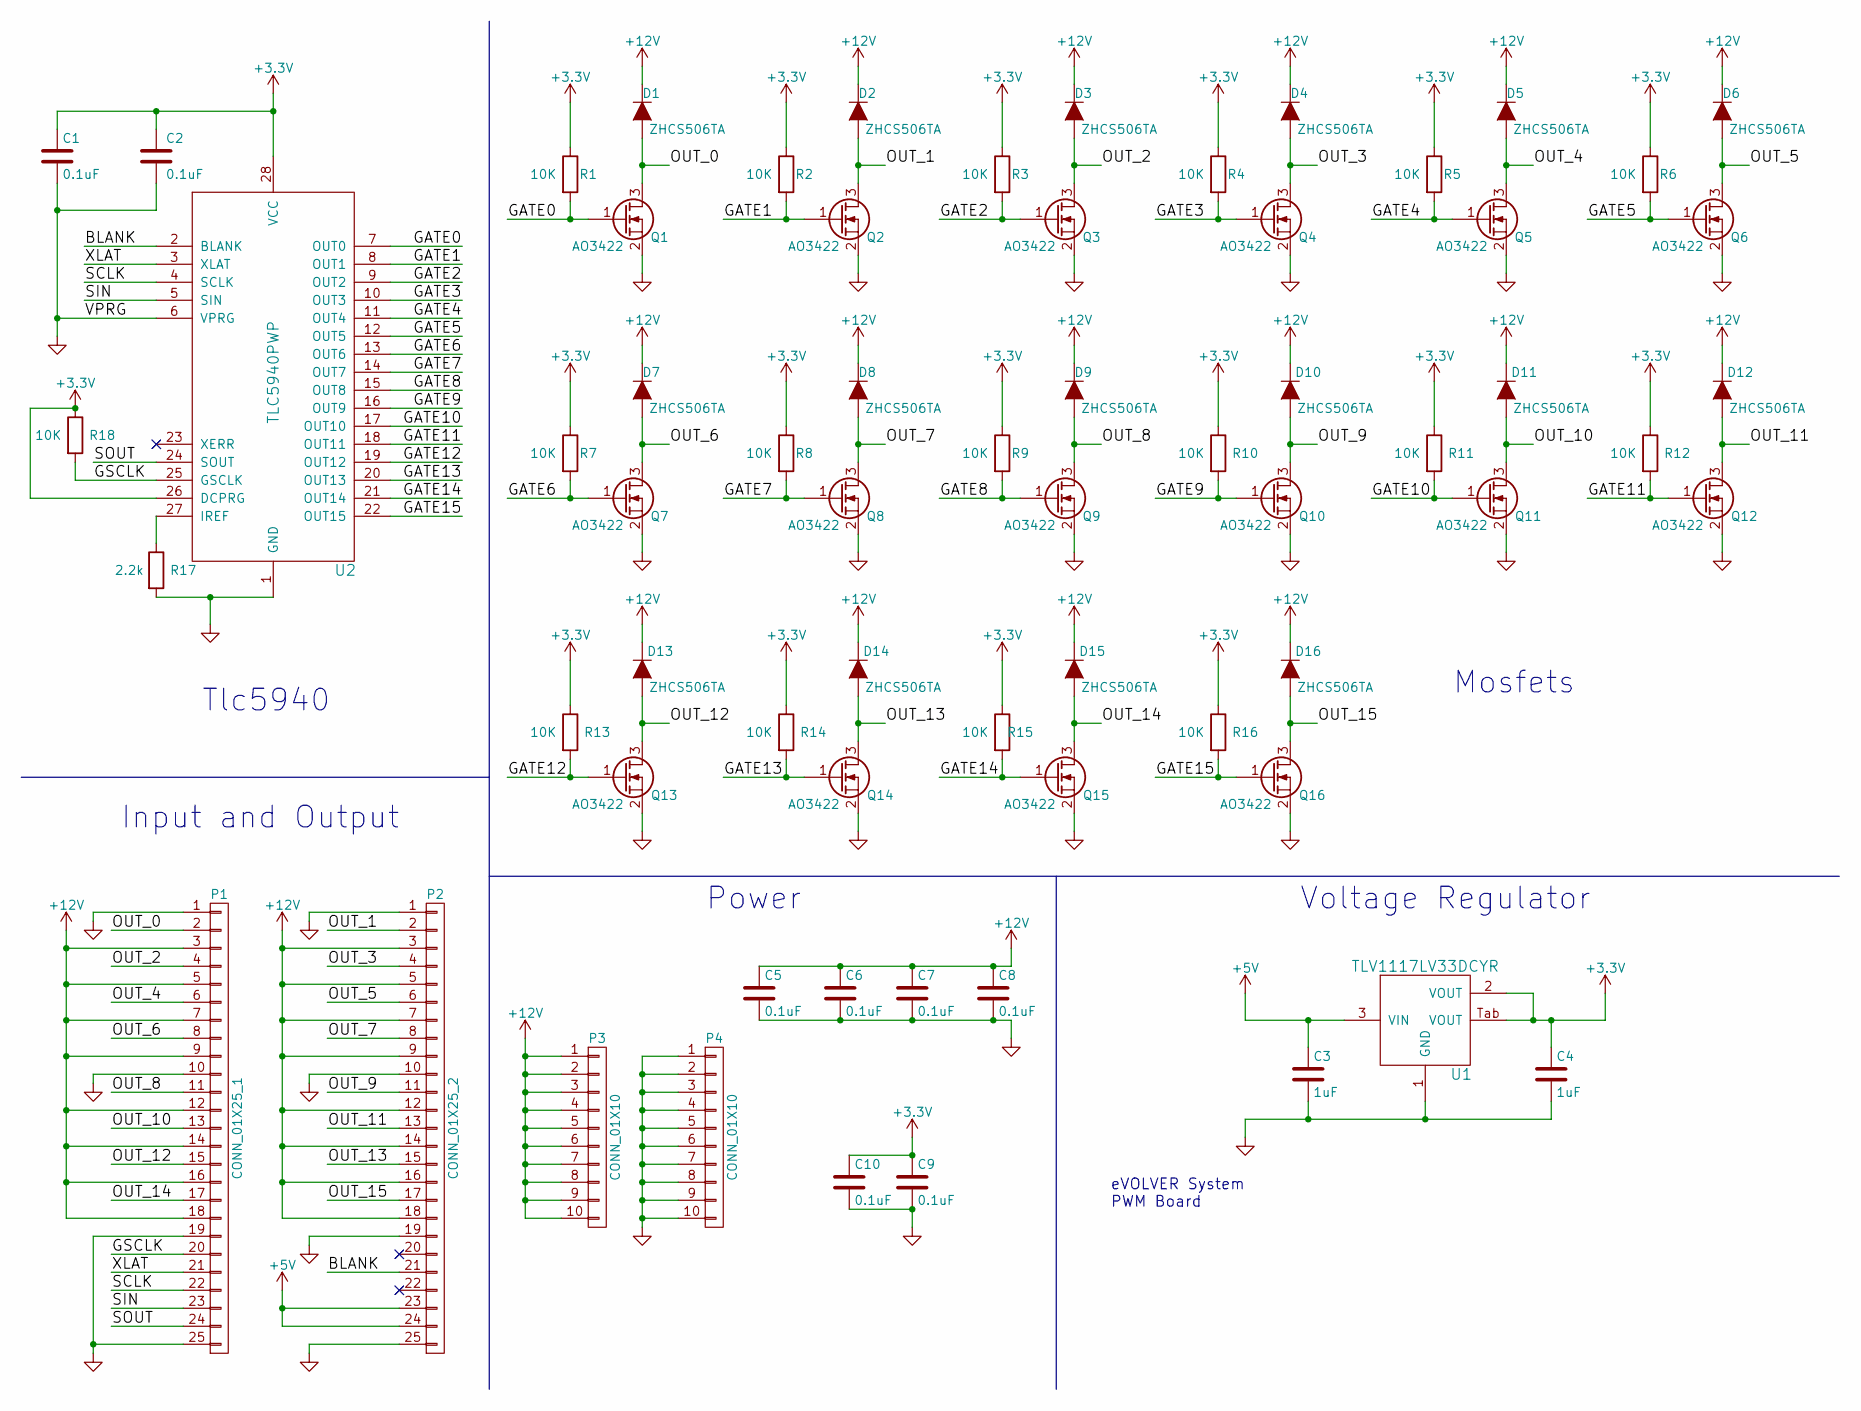
[picture p14: schematic PWM.kicad_sch]

Parts:
C1, C2, C5, C6, C7, C8, C9, C10: 0.1uF; C_0402
C3, C4: 1uF; C_0402
D1, D2, D3, D4, D5, D6, D7, D8, D9, D10, D11, D12, D13, D14, D15, D16: ZHCS506TA
P1: CONN_01X25_1; 25_pin_10in
P2: CONN_01X25_2; 25_pin_10in
P3, P4: CONN_01X10; 10pin_tenth_in_V2
Q1, Q2, Q3, Q4, Q5, Q6, Q7, Q8, Q9, Q10, Q11, Q12, Q13, Q14, Q15, Q16: AO3422
R1, R2, R3, R4, R5, R6, R7, R8, R9, R10, R11, R12, R13, R14, R15, R16, R18: 10K; R_0402
R17: 2.2k; R_0402
U1: TLV1117LV33DCYR
U2: TLC5940PWP

Connections:
+3.3V: C1.1, C2.1, C4.1, C9.1, C10.1, R1.1, R2.1, R3.1, R4.1, R5.1, R6.1, R7.1, R8.1, R9.1, R10.1, R11.1, R12.1, R13.1, R14.1, R15.1, R16.1, R18.1, U1.2 (VOUT), U1.Tab (VOUT), U2.26 (DCPRG), U2.28 (VCC)
+5V: C3.1, P2.23, P2.24, U1.3 (VIN)
+12V: C5.1, C6.1, C7.1, C8.1, D1.1 (K), D2.1 (K), D3.1 (K), D4.1 (K), D5.1 (K), D6.1 (K), D7.1 (K), D8.1 (K), D9.1 (K), D10.1 (K), D11.1 (K), D12.1 (K), D13.1 (K), D14.1 (K), D15.1 (K), D16.1 (K), P1.3, P1.5, P1.7, P1.9, P1.12, P1.14, P1.16, P1.18, P2.3, P2.5, P2.7, P2.9, P2.12, P2.14, P2.16, P2.18, P3.1, P3.2, P3.3, P3.4, P3.5, P3.6, P3.7, P3.8, P3.9, P3.10
BLANK: P2.21, U2.2 (BLANK)
GATE0: Q1.1 (G), R1.2, U2.7 (OUT0)
GATE1: Q2.1 (G), R2.2, U2.8 (OUT1)
GATE2: Q3.1 (G), R3.2, U2.9 (OUT2)
GATE3: Q4.1 (G), R4.2, U2.10 (OUT3)
GATE4: Q5.1 (G), R5.2, U2.11 (OUT4)
GATE5: Q6.1 (G), R6.2, U2.12 (OUT5)
GATE6: Q7.1 (G), R7.2, U2.13 (OUT6)
GATE7: Q8.1 (G), R8.2, U2.14 (OUT7)
GATE8: Q9.1 (G), R9.2, U2.15 (OUT8)
GATE9: Q10.1 (G), R10.2, U2.16 (OUT9)
GATE10: Q11.1 (G), R11.2, U2.17 (OUT10)
GATE11: Q12.1 (G), R12.2, U2.18 (OUT11)
GATE12: Q13.1 (G), R13.2, U2.19 (OUT12)
GATE13: Q14.1 (G), R14.2, U2.20 (OUT13)
GATE14: Q15.1 (G), R15.2, U2.21 (OUT14)
GATE15: Q16.1 (G), R16.2, U2.22 (OUT15)
GND: C1.2, C2.2, C3.2, C4.2, C5.2, C6.2, C7.2, C8.2, C9.2, C10.2, P1.1, P1.10, P1.19, P1.25, P2.1, P2.10, P2.19, P2.25, P4.1, P4.2, P4.3, P4.4, P4.5, P4.6, P4.7, P4.8, P4.9, P4.10, Q1.2 (S), Q2.2 (S), Q3.2 (S), Q4.2 (S), Q5.2 (S), Q6.2 (S), Q7.2 (S), Q8.2 (S), Q9.2 (S), Q10.2 (S), Q11.2 (S), Q12.2 (S), Q13.2 (S), Q14.2 (S), Q15.2 (S), Q16.2 (S), R17.2, U1.1 (GND), U2.1 (GND), U2.6 (VPRG)
GSCLK: P1.20, R18.2, U2.25 (GSCLK)
unnamed: R17.1, U2.27 (IREF)
OUT_0: D1.3 (A), P1.2, Q1.3 (D)
OUT_1: D2.3 (A), P2.2, Q2.3 (D)
OUT_2: D3.3 (A), P1.4, Q3.3 (D)
OUT_3: D4.3 (A), P2.4, Q4.3 (D)
OUT_4: D5.3 (A), P1.6, Q5.3 (D)
OUT_5: D6.3 (A), P2.6, Q6.3 (D)
OUT_6: D7.3 (A), P1.8, Q7.3 (D)
OUT_7: D8.3 (A), P2.8, Q8.3 (D)
OUT_8: D9.3 (A), P1.11, Q9.3 (D)
OUT_9: D10.3 (A), P2.11, Q10.3 (D)
OUT_10: D11.3 (A), P1.13, Q11.3 (D)
OUT_11: D12.3 (A), P2.13, Q12.3 (D)
OUT_12: D13.3 (A), P1.15, Q13.3 (D)
OUT_13: D14.3 (A), P2.15, Q14.3 (D)
OUT_14: D15.3 (A), P1.17, Q15.3 (D)
OUT_15: D16.3 (A), P2.17, Q16.3 (D)
SCLK: P1.22, U2.4 (SCLK)
SIN: P1.23, U2.5 (SIN)
SOUT: P1.24, U2.24 (SOUT)
XLAT: P1.21, U2.3 (XLAT)

Notes on the sheet:
Power
Mosfets
Voltage Regulator
Input and Output
eVOLVER System PWM Board
Tlc5940
