ACA-CNPEM/evolver-harware/Pi-HAT/Projeto/Pi-Hat.kicad_sch

## KiCad design Pi-HAT/Projeto/Pi-Hat.kicad_sch (2023-03-21)

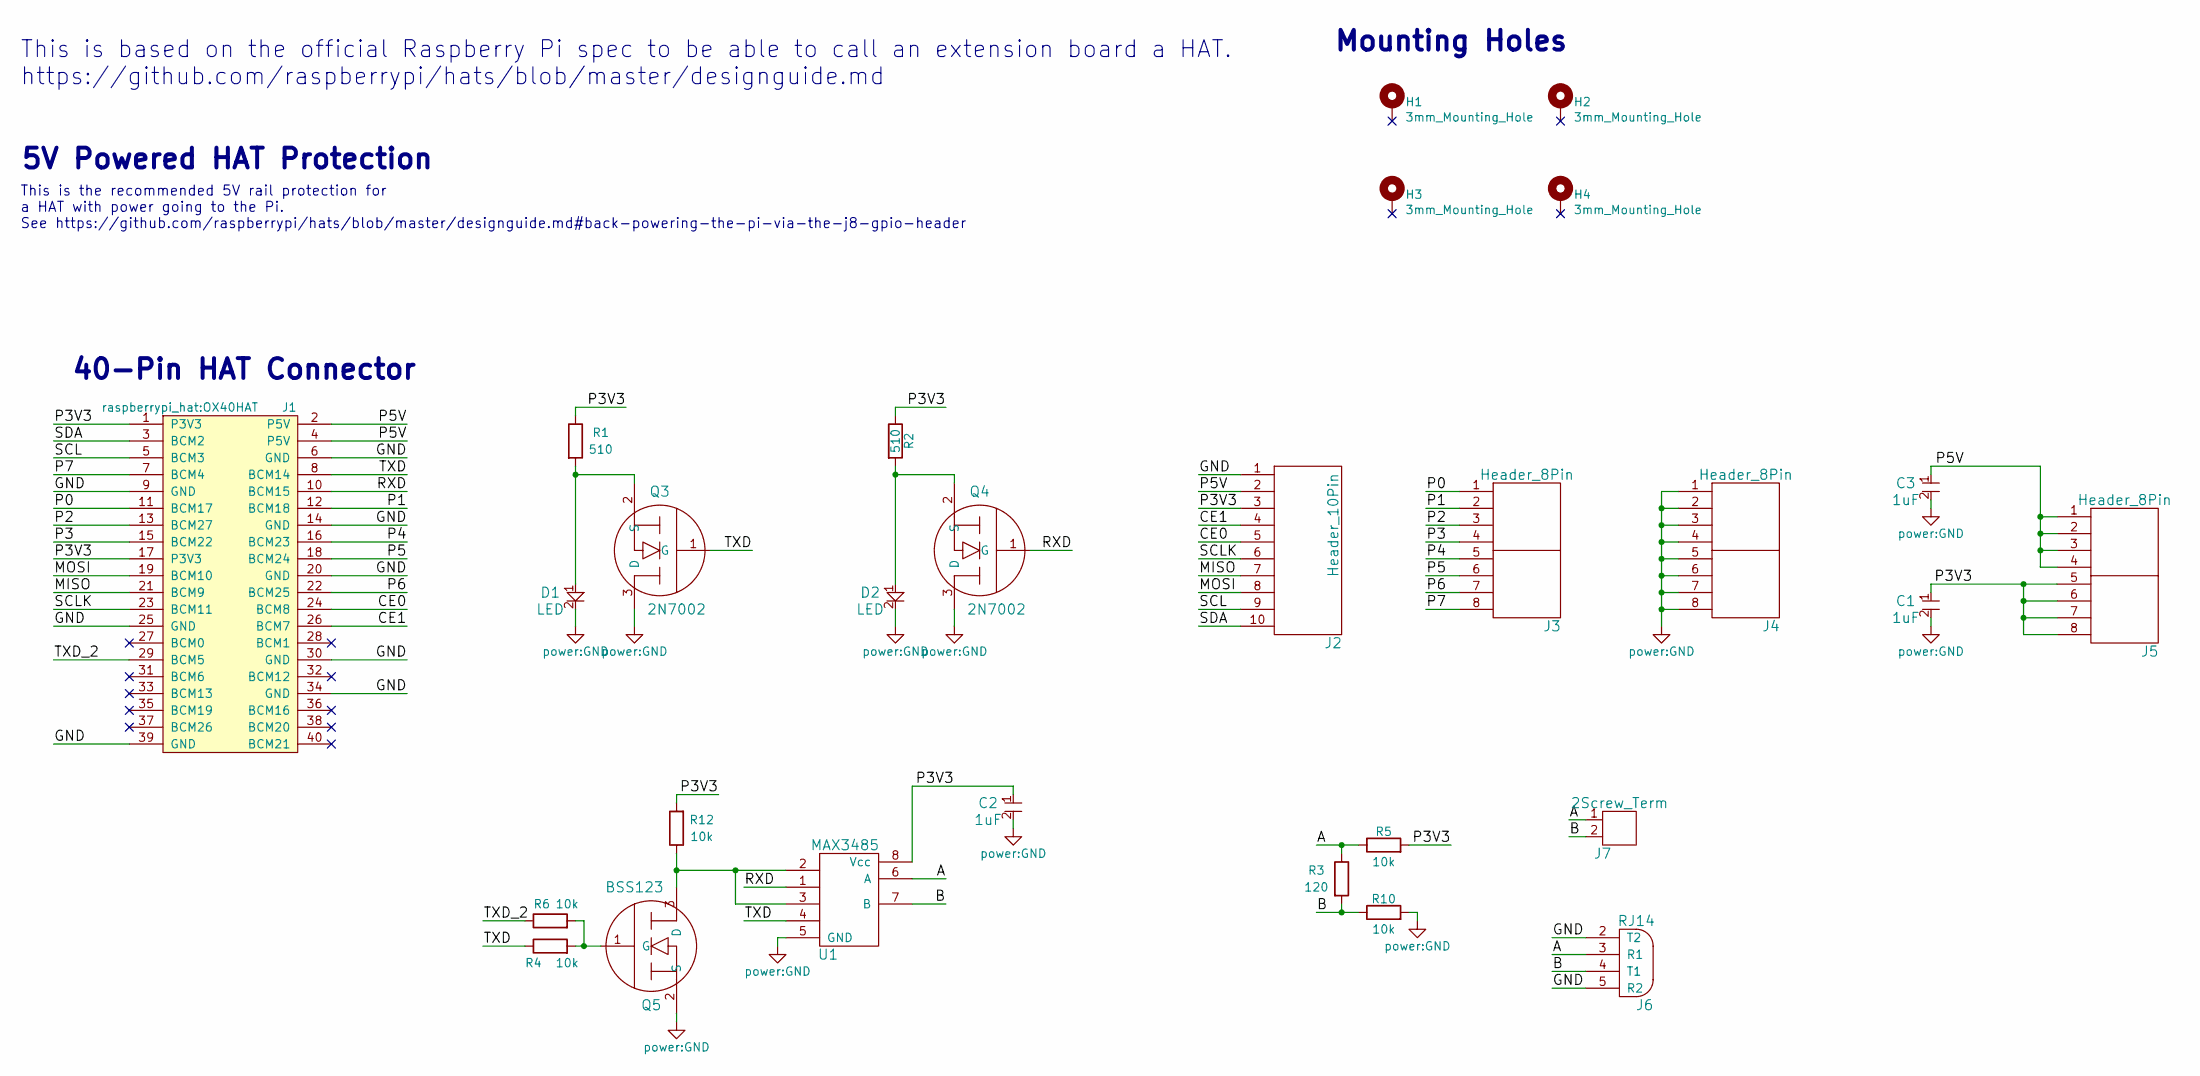
[picture p15: schematic Pi-Hat.kicad_sch]

Parts:
C1, C2, C3: 1uF; C_0805_HS
D1, D2: LED; LED_0603
H1, H2, H3, H4: 3mm_Mounting_Hole; MH_plated
J1: raspberrypi_hat:OX40HAT; Connector_PinSocket_2.54mm
J2: Header_10Pin; 10Pin_Header
J3, J4, J5: Header_8Pin; 8Pin_Header
J6: RJ14; 609-5080-ND
J7: 2Screw_Term; 277-1667-ND
Q3, Q4: 2N7002
Q5: BSS123; 2N7002
R1, R2: 510; R_805_HS
R3: 120; R_805_HS
R4, R5, R6, R10, R12: 10k; R_805_HS
U1: MAX3485; SO-8

Connections:
A: J6.3 (R1), J7.1, R3.1, R5.1, U1.6 (A)
B: J6.4 (T1), J7.2, R3.2, R10.1, U1.7 (B)
CE0: J1.24 (BCM8), J2.5
CE1: J1.26 (BCM7), J2.4
GND: J1.6 (GND), J1.9 (GND), J1.14 (GND), J1.20 (GND), J1.25 (GND), J1.30 (GND), J1.34 (GND), J1.39 (GND), J2.1, J6.2 (T2), J6.5 (R2)
MISO: J1.21 (BCM9), J2.7
MOSI: J1.19 (BCM10), J2.8
unnamed: D1.1, Q3.2 (S), R1.2
unnamed: D2.1, Q4.2 (S), R2.2
unnamed: Q5.1 (G), R4.2, R6.2
unnamed: Q5.3 (D), R12.1, U1.2, U1.3
P0: J1.11 (BCM17), J3.1
P1: J1.12 (BCM18), J3.2
P2: J1.13 (BCM27), J3.3
P3: J1.15 (BCM22), J3.4
P3V3: C1.1, C2.1, J1.1 (P3V3), J1.17 (P3V3), J2.3, J5.5, J5.6, J5.7, J5.8, R1.1, R2.1, R5.2, R12.2, U1.8 (Vcc)
P4: J1.16 (BCM23), J3.5
P5: J1.18 (BCM24), J3.6
P5V: C3.1, J1.2 (P5V), J1.4 (P5V), J2.2, J5.1, J5.2, J5.3, J5.4
P6: J1.22 (BCM25), J3.7
P7: J1.7 (BCM4), J3.8
RXD: J1.10 (BCM15), Q4.1 (G), U1.1
SCL: J1.5 (BCM3), J2.9
SCLK: J1.23 (BCM11), J2.6
SDA: J1.3 (BCM2), J2.10
TXD: J1.8 (BCM14), Q3.1 (G), R4.1, U1.4
TXD_2: J1.29 (BCM5), R6.1
power:GND: C1.2, C2.2, C3.2, D1.2, D2.2, J4.1, J4.2, J4.3, J4.4, J4.5, J4.6, J4.7, J4.8, Q3.3 (D), Q4.3 (D), Q5.2 (S), R10.2, U1.5 (GND)

Notes on the sheet:
Mounting Holes
5V Powered HAT Protection
This is based on the official Raspberry Pi spec to be able to call an extension board a HAT. https://github.com/raspberrypi/hats/blob/master/designguide.md
This is the recommended 5V rail protection for a HAT with power going to the Pi. See https://github.com/raspberrypi/hats/blob/master/designguide.md#back-powering-the-pi-via-the-j8-gpio-header
40-Pin HAT Connector
