ACA-CNPEM/evolver-harware/RS485/Projeto/RS485.kicad_sch

## KiCad design RS485/Projeto/RS485.kicad_sch (2023-03-21)

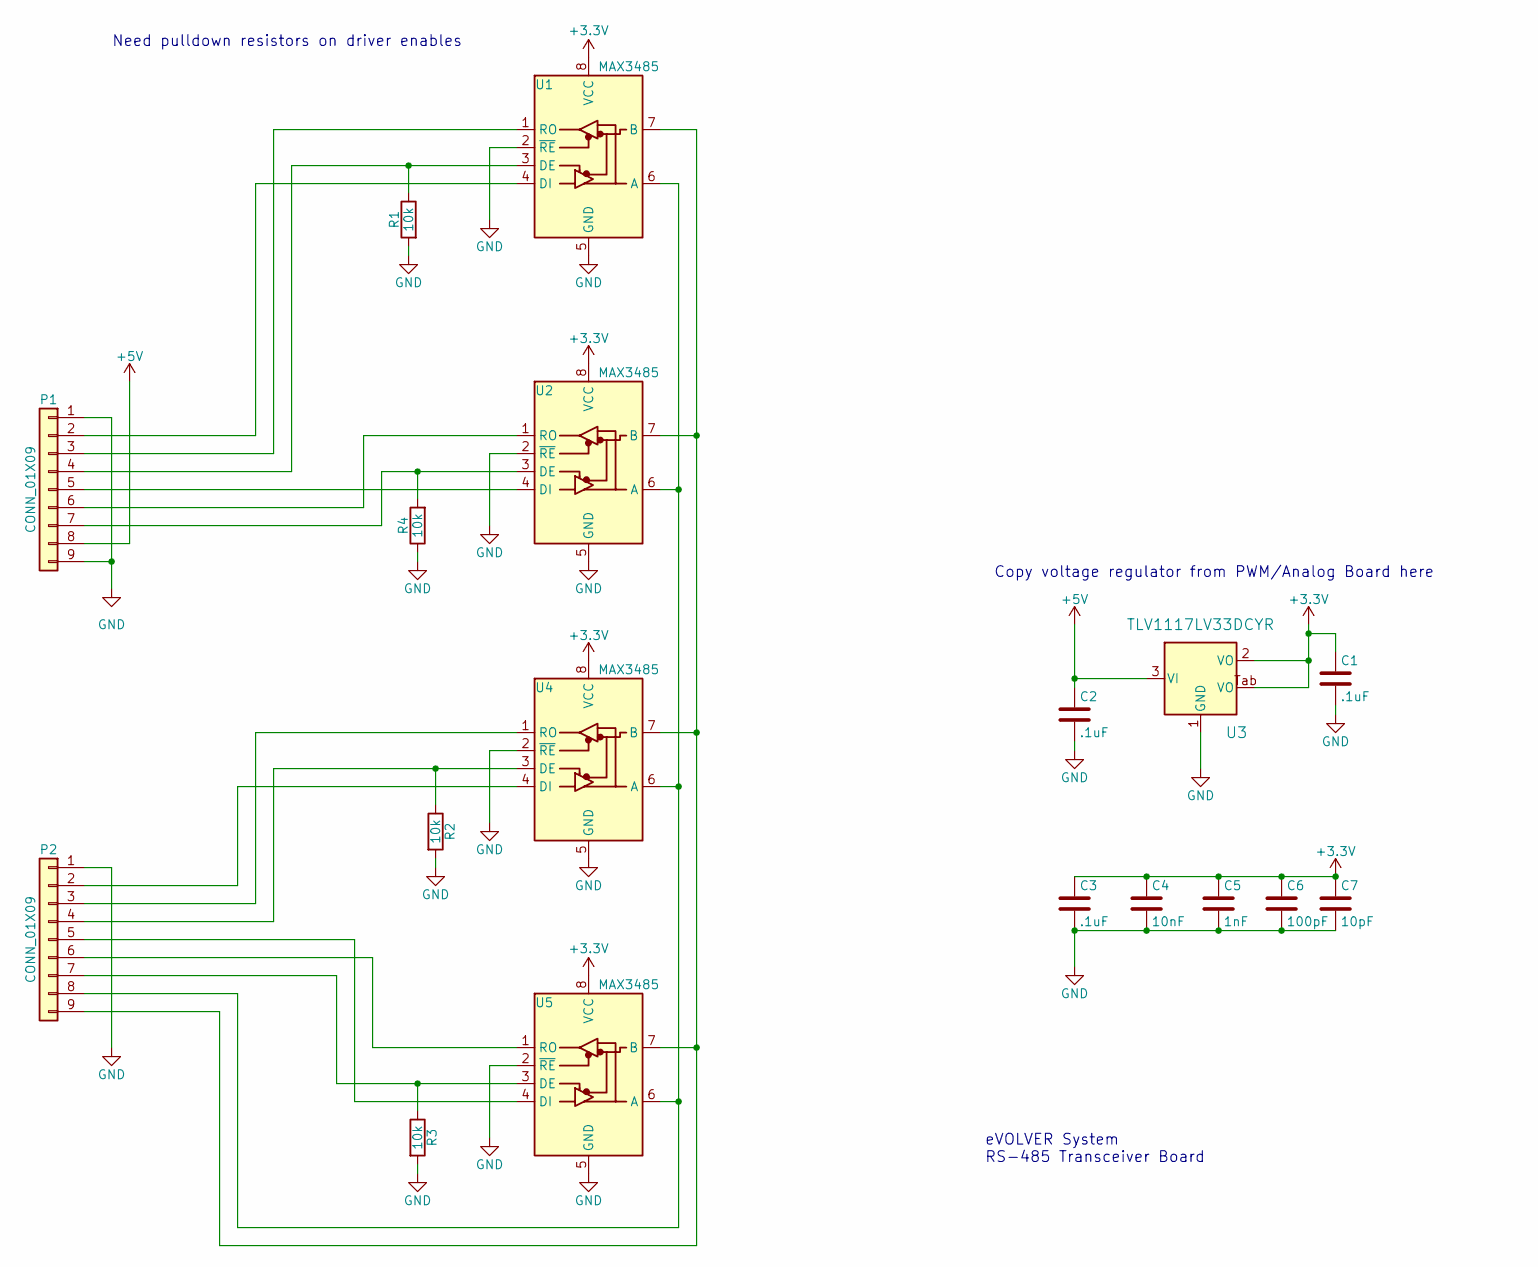
[picture p16: schematic RS485.kicad_sch]

Parts:
C1, C2, C3: .1uF; C_0402
C4: 10nF; C_0402
C5: 1nF; C_0402
C6: 100pF; C_0402
C7: 10pF; C_0402
P1, P2: CONN_01X09; 9_pin_10in
R1, R2, R3, R4: 10k; R_0402
U1, U2, U4, U5: MAX3485; SO-8
U3: TLV1117LV33DCYR

Connections:
+3.3V: C1.1, C3.1, C4.1, C5.1, C6.1, C7.1, U1.8 (VCC), U2.8 (VCC), U3.2 (VO), U3.Tab (VO), U4.8 (VCC), U5.8 (VCC)
+5V: C2.1, P1.8, U3.3 (VI)
GND: C1.2, C2.2, C3.2, C4.2, C5.2, C6.2, C7.2, P1.1, P1.9, P2.1, R1.2, R2.2, R3.2, R4.1, U1.2 (~RE), U1.5 (GND), U2.2 (~RE), U2.5 (GND), U3.1 (GND), U4.2 (~RE), U4.5 (GND), U5.2 (~RE), U5.5 (GND)
unnamed: P1.2, U1.4 (DI)
unnamed: P1.3, U1.1 (RO)
unnamed: P1.4, R1.1, U1.3 (DE)
unnamed: P1.5, U2.4 (DI)
unnamed: P1.6, U2.1 (RO)
unnamed: P1.7, R4.2, U2.3 (DE)
unnamed: P2.2, U4.4 (DI)
unnamed: P2.3, U4.1 (RO)
unnamed: P2.4, R2.1, U4.3 (DE)
unnamed: P2.5, U5.4 (DI)
unnamed: P2.6, U5.1 (RO)
unnamed: P2.7, R3.1, U5.3 (DE)
unnamed: P2.8, U1.6 (A), U2.6 (A), U4.6 (A), U5.6 (A)
unnamed: P2.9, U1.7 (B), U2.7 (B), U4.7 (B), U5.7 (B)

Notes on the sheet:
eVOLVER System RS-485 Transceiver Board
Need pulldown resistors on driver enables
Copy voltage regulator from PWM/Analog Board here
