ACA-CNPEM/evolver-harware/Motherboard/Projeto/Motherboard.kicad_sch

## KiCad design Motherboard/Projeto/Motherboard.kicad_sch (2023-04-28)

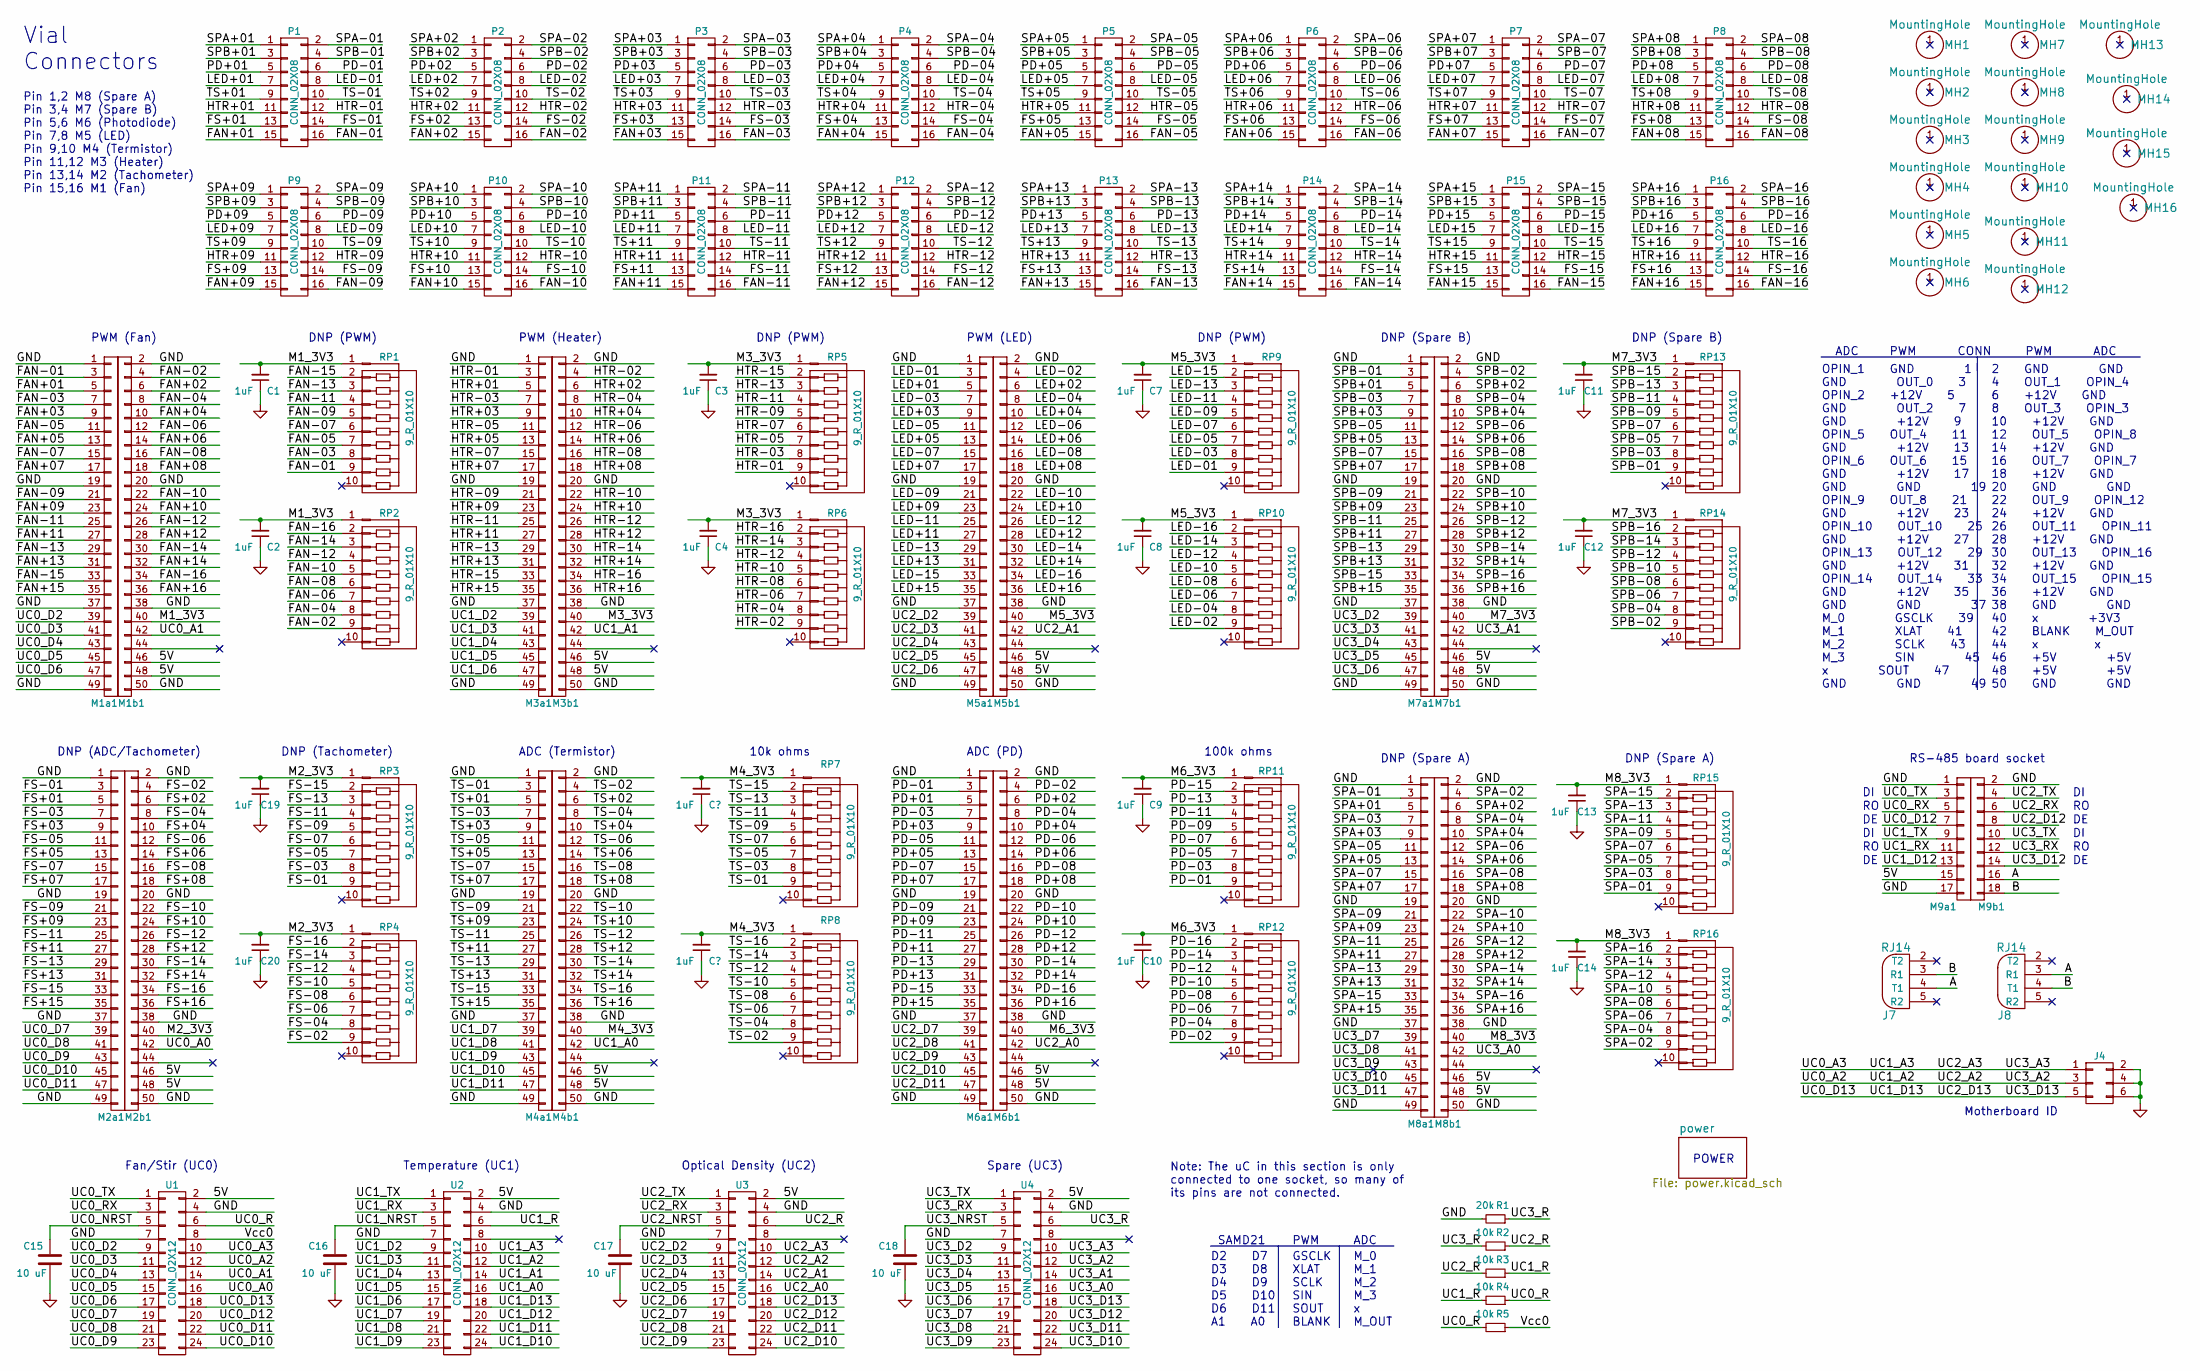
[picture p17: schematic Motherboard.kicad_sch]

Parts:
C1, C2, C3, C4, C7, C8, C9, C10, C11, C12, C13, C14, C19, C20: 1uF; FK18X5R0J105K
C15, C16, C17, C18: 10 uF; FK18X5R0J105K
J4: 2x3_pin_10in
J7: RJ14; 609-1064-ND
J8: RJ14; 609-5080-ND
M1a1, M2a1, M3a1, M4a1, M5a1, M6a1, M7a1, M8a1: conn:CONN_01X25_LEFT; 25_pin_10in_left
M1b1, M2b1, M3b1, M4b1, M5b1, M6b1, M7b1, M8b1: conn:CONN_01X25_RIGHT; 25_pin_10in_RIGHT
M9a1: conn:CONN_01X09_LEFT; 9_pin_10in_LEFT
M9b1: conn:CONN_01X09_RIGHT; 9_pin_10in_RIGHT
MH1, MH2, MH3, MH4, MH5, MH6, MH7, MH8, MH9, MH10, MH11, MH12, MH13, MH14, MH15, MH16: MountingHole; mh_632
P1, P2, P3, P4, P5, P6, P7, P8, P9, P10, P11, P12, P13, P14, P15, P16: CONN_02X08; 2x8_pin_10in
R1: 20k; R_200mil
R2, R3, R4, R5: 10k; R_200mil
RP1, RP2, RP3, RP4, RP5, RP6, RP7, RP8, RP9, RP10, RP11, RP12, RP13, RP14, RP15, RP16: 9_R_01X10; 10_pin_10in_BW
U1, U2, U3, U4: CONN_02X12; 24_pin_10in

Connections:
5V: M1b1.46, M1b1.48, M2b1.46, M2b1.48, M3b1.46, M3b1.48, M4b1.46, M4b1.48, M5b1.46, M5b1.48, M6b1.46, M6b1.48, M7b1.46, M7b1.48, M8b1.46, M8b1.48, M9a1.15, U1.2, U2.2, U3.2, U4.2
A: J7.4 (T1), J8.3 (R1), M9b1.16
B: J7.3 (R1), J8.4 (T1), M9b1.18
FAN+01: M1a1.5, P1.15
FAN+02: M1b1.6, P2.15
FAN+03: M1a1.9, P3.15
FAN+04: M1b1.10, P4.15
FAN+05: M1a1.13, P5.15
FAN+06: M1b1.14, P6.15
FAN+07: M1a1.17, P7.15
FAN+08: M1b1.18, P8.15
FAN+09: M1a1.23, P9.15
FAN+10: M1b1.24, P10.15
FAN+11: M1a1.27, P11.15
FAN+12: M1b1.28, P12.15
FAN+13: M1a1.31, P13.15
FAN+14: M1b1.32, P14.15
FAN+15: M1a1.35, P15.15
FAN+16: M1b1.36, P16.15
FAN-01: M1a1.3, P1.16, RP1.9
FAN-02: M1b1.4, P2.16, RP2.9
FAN-03: M1a1.7, P3.16, RP1.8
FAN-04: M1b1.8, P4.16, RP2.8
FAN-05: M1a1.11, P5.16, RP1.7
FAN-06: M1b1.12, P6.16, RP2.7
FAN-07: M1a1.15, P7.16, RP1.6
FAN-08: M1b1.16, P8.16, RP2.6
FAN-09: M1a1.21, P9.16, RP1.5
FAN-10: M1b1.22, P10.16, RP2.5
FAN-11: M1a1.25, P11.16, RP1.4
FAN-12: M1b1.26, P12.16, RP2.4
FAN-13: M1a1.29, P13.16, RP1.3
FAN-14: M1b1.30, P14.16, RP2.3
FAN-15: M1a1.33, P15.16, RP1.2
FAN-16: M1b1.34, P16.16, RP2.2
FS+01: M2a1.5, P1.13
FS+02: M2b1.6, P2.13
FS+03: M2a1.9, P3.13
FS+04: M2b1.10, P4.13
FS+05: M2a1.13, P5.13
FS+06: M2b1.14, P6.13
FS+07: M2a1.17, P7.13
FS+08: M2b1.18, P8.13
FS+09: M2a1.23, P9.13
FS+10: M2b1.24, P10.13
FS+11: M2a1.27, P11.13
FS+12: M2b1.28, P12.13
FS+13: M2a1.31, P13.13
FS+14: M2b1.32, P14.13
FS+15: M2a1.35, P15.13
FS+16: M2b1.36, P16.13
FS-01: M2a1.3, P1.14, RP3.9
FS-02: M2b1.4, P2.14, RP4.9
FS-03: M2a1.7, P3.14, RP3.8
FS-04: M2b1.8, P4.14, RP4.8
FS-05: M2a1.11, P5.14, RP3.7
FS-06: M2b1.12, P6.14, RP4.7
FS-07: M2a1.15, P7.14, RP3.6
FS-08: M2b1.16, P8.14, RP4.6
FS-09: M2a1.21, P9.14, RP3.5
FS-10: M2b1.22, P10.14, RP4.5
FS-11: M2a1.25, P11.14, RP3.4
FS-12: M2b1.26, P12.14, RP4.4
FS-13: M2a1.29, P13.14, RP3.3
FS-14: M2b1.30, P14.14, RP4.3
FS-15: M2a1.33, P15.14, RP3.2
FS-16: M2b1.34, P16.14, RP4.2
GND: C1.1, C2.1, C3.1, C4.1, C7.1, C8.1, C9.1, C10.1, C11.1, C12.1, C13.1, C14.1, C15.2, C16.2, C17.2, C18.2, C19.1, C20.1, J4.2, J4.4, J4.6, M1a1.1, M1a1.19, M1a1.37, M1a1.49, M1b1.2, M1b1.20, M1b1.38, M1b1.50, M2a1.1, M2a1.19, M2a1.37, M2a1.49, M2b1.2, M2b1.20, M2b1.38, M2b1.50, M3a1.1, M3a1.19, M3a1.37, M3a1.49, M3b1.2, M3b1.20, M3b1.38, M3b1.50, M4a1.1, M4a1.19, M4a1.37, M4a1.49, M4b1.2, M4b1.20, M4b1.38, M4b1.50, M5a1.1, M5a1.19, M5a1.37, M5a1.49, M5b1.2, M5b1.20, M5b1.38, M5b1.50, M6a1.1, M6a1.19, M6a1.37, M6a1.49, M6b1.2, M6b1.20, M6b1.38, M6b1.50, M7a1.1, M7a1.19, M7a1.37, M7a1.49, M7b1.2, M7b1.20, M7b1.38, M7b1.50, M8a1.1, M8a1.19, M8a1.37, M8a1.49, M8b1.2, M8b1.20, M8b1.38, M8b1.50, M9a1.1, M9a1.17, M9b1.2, R1.2, U1.4, U1.7, U2.4, U2.7, U3.4, U3.7, U4.4, U4.7
HTR+01: M3a1.5, P1.11
HTR+02: M3b1.6, P2.11
HTR+03: M3a1.9, P3.11
HTR+04: M3b1.10, P4.11
HTR+05: M3a1.13, P5.11
HTR+06: M3b1.14, P6.11
HTR+07: M3a1.17, P7.11
HTR+08: M3b1.18, P8.11
HTR+09: M3a1.23, P9.11
HTR+10: M3b1.24, P10.11
HTR+11: M3a1.27, P11.11
HTR+12: M3b1.28, P12.11
HTR+13: M3a1.31, P13.11
HTR+14: M3b1.32, P14.11
HTR+15: M3a1.35, P15.11
HTR+16: M3b1.36, P16.11
HTR-01: M3a1.3, P1.12, RP5.9
HTR-02: M3b1.4, P2.12, RP6.9
HTR-03: M3a1.7, P3.12, RP5.8
HTR-04: M3b1.8, P4.12, RP6.8
HTR-05: M3a1.11, P5.12, RP5.7
HTR-06: M3b1.12, P6.12, RP6.7
HTR-07: M3a1.15, P7.12, RP5.6
HTR-08: M3b1.16, P8.12, RP6.6
HTR-09: M3a1.21, P9.12, RP5.5
HTR-10: M3b1.22, P10.12, RP6.5
HTR-11: M3a1.25, P11.12, RP5.4
HTR-12: M3b1.26, P12.12, RP6.4
HTR-13: M3a1.29, P13.12, RP5.3
HTR-14: M3b1.30, P14.12, RP6.3
HTR-15: M3a1.33, P15.12, RP5.2
HTR-16: M3b1.34, P16.12, RP6.2
LED+01: M5a1.5, P1.7
LED+02: M5b1.6, P2.7
LED+03: M5a1.9, P3.7
LED+04: M5b1.10, P4.7
LED+05: M5a1.13, P5.7
LED+06: M5b1.14, P6.7
LED+07: M5a1.17, P7.7
LED+08: M5b1.18, P8.7
LED+09: M5a1.23, P9.7
LED+10: M5b1.24, P10.7
LED+11: M5a1.27, P11.7
LED+12: M5b1.28, P12.7
LED+13: M5a1.31, P13.7
LED+14: M5b1.32, P14.7
LED+15: M5a1.35, P15.7
LED+16: M5b1.36, P16.7
LED-01: M5a1.3, P1.8, RP9.9
LED-02: M5b1.4, P2.8, RP10.9
LED-03: M5a1.7, P3.8, RP9.8
LED-04: M5b1.8, P4.8, RP10.8
LED-05: M5a1.11, P5.8, RP9.7
LED-06: M5b1.12, P6.8, RP10.7
LED-07: M5a1.15, P7.8, RP9.6
LED-08: M5b1.16, P8.8, RP10.6
LED-09: M5a1.21, P9.8, RP9.5
LED-10: M5b1.22, P10.8, RP10.5
LED-11: M5a1.25, P11.8, RP9.4
LED-12: M5b1.26, P12.8, RP10.4
LED-13: M5a1.29, P13.8, RP9.3
LED-14: M5b1.30, P14.8, RP10.3
LED-15: M5a1.33, P15.8, RP9.2
LED-16: M5b1.34, P16.8, RP10.2
M1_3V3: C1.2, C2.2, M1b1.40, RP1.1, RP2.1
M2_3V3: C19.2, C20.2, M2b1.40, RP3.1, RP4.1
M3_3V3: C3.2, C4.2, M3b1.40, RP5.1, RP6.1
M4_3V3: M4b1.40, RP7.1, RP8.1
M5_3V3: C7.2, C8.2, M5b1.40, RP9.1, RP10.1
M6_3V3: C9.2, C10.2, M6b1.40, RP11.1, RP12.1
M7_3V3: C11.2, C12.2, M7b1.40, RP13.1, RP14.1
M8_3V3: C13.2, C14.2, M8b1.40, RP15.1, RP16.1
PD+01: M6a1.5, P1.5
PD+02: M6b1.6, P2.5
PD+03: M6a1.9, P3.5
PD+04: M6b1.10, P4.5
PD+05: M6a1.13, P5.5
PD+06: M6b1.14, P6.5
PD+07: M6a1.17, P7.5
PD+08: M6b1.18, P8.5
PD+09: M6a1.23, P9.5
PD+10: M6b1.24, P10.5
PD+11: M6a1.27, P11.5
PD+12: M6b1.28, P12.5
PD+13: M6a1.31, P13.5
PD+14: M6b1.32, P14.5
PD+15: M6a1.35, P15.5
PD+16: M6b1.36, P16.5
PD-01: M6a1.3, P1.6, RP11.9
PD-02: M6b1.4, P2.6, RP12.9
PD-03: M6a1.7, P3.6, RP11.8
PD-04: M6b1.8, P4.6, RP12.8
PD-05: M6a1.11, P5.6, RP11.7
PD-06: M6b1.12, P6.6, RP12.7
PD-07: M6a1.15, P7.6, RP11.6
PD-08: M6b1.16, P8.6, RP12.6
PD-09: M6a1.21, P9.6, RP11.5
PD-10: M6b1.22, P10.6, RP12.5
PD-11: M6a1.25, P11.6, RP11.4
PD-12: M6b1.26, P12.6, RP12.4
PD-13: M6a1.29, P13.6, RP11.3
PD-14: M6b1.30, P14.6, RP12.3
PD-15: M6a1.33, P15.6, RP11.2
PD-16: M6b1.34, P16.6, RP12.2
SPA+01: M8a1.5, P1.1
SPA+02: M8b1.6, P2.1
SPA+03: M8a1.9, P3.1
SPA+04: M8b1.10, P4.1
SPA+05: M8a1.13, P5.1
SPA+06: M8b1.14, P6.1
SPA+07: M8a1.17, P7.1
SPA+08: M8b1.18, P8.1
SPA+09: M8a1.23, P9.1
SPA+10: M8b1.24, P10.1
SPA+11: M8a1.27, P11.1
SPA+12: M8b1.28, P12.1
SPA+13: M8a1.31, P13.1
SPA+14: M8b1.32, P14.1
SPA+15: M8a1.35, P15.1
SPA+16: M8b1.36, P16.1
SPA-01: M8a1.3, P1.2, RP15.9
SPA-02: M8b1.4, P2.2, RP16.9
SPA-03: M8a1.7, P3.2, RP15.8
SPA-04: M8b1.8, P4.2, RP16.8
SPA-05: M8a1.11, P5.2, RP15.7
SPA-06: M8b1.12, P6.2, RP16.7
SPA-07: M8a1.15, P7.2, RP15.6
SPA-08: M8b1.16, P8.2, RP16.6
SPA-09: M8a1.21, P9.2, RP15.5
SPA-10: M8b1.22, P10.2, RP16.5
SPA-11: M8a1.25, P11.2, RP15.4
SPA-12: M8b1.26, P12.2, RP16.4
SPA-13: M8a1.29, P13.2, RP15.3
SPA-14: M8b1.30, P14.2, RP16.3
SPA-15: M8a1.33, P15.2, RP15.2
SPA-16: M8b1.34, P16.2, RP16.2
SPB+01: M7a1.5, P1.3
SPB+02: M7b1.6, P2.3
SPB+03: M7a1.9, P3.3
SPB+04: M7b1.10, P4.3
SPB+05: M7a1.13, P5.3
SPB+06: M7b1.14, P6.3
SPB+07: M7a1.17, P7.3
SPB+08: M7b1.18, P8.3
SPB+09: M7a1.23, P9.3
SPB+10: M7b1.24, P10.3
SPB+11: M7a1.27, P11.3
SPB+12: M7b1.28, P12.3
SPB+13: M7a1.31, P13.3
SPB+14: M7b1.32, P14.3
SPB+15: M7a1.35, P15.3
SPB+16: M7b1.36, P16.3
SPB-01: M7a1.3, P1.4, RP13.9
SPB-02: M7b1.4, P2.4, RP14.9
SPB-03: M7a1.7, P3.4, RP13.8
SPB-04: M7b1.8, P4.4, RP14.8
SPB-05: M7a1.11, P5.4, RP13.7
SPB-06: M7b1.12, P6.4, RP14.7
SPB-07: M7a1.15, P7.4, RP13.6
SPB-08: M7b1.16, P8.4, RP14.6
SPB-09: M7a1.21, P9.4, RP13.5
SPB-10: M7b1.22, P10.4, RP14.5
SPB-11: M7a1.25, P11.4, RP13.4
SPB-12: M7b1.26, P12.4, RP14.4
SPB-13: M7a1.29, P13.4, RP13.3
SPB-14: M7b1.30, P14.4, RP14.3
SPB-15: M7a1.33, P15.4, RP13.2
SPB-16: M7b1.34, P16.4, RP14.2
TS+01: M4a1.5, P1.9
TS+02: M4b1.6, P2.9
TS+03: M4a1.9, P3.9
TS+04: M4b1.10, P4.9
TS+05: M4a1.13, P5.9
TS+06: M4b1.14, P6.9
TS+07: M4a1.17, P7.9
TS+08: M4b1.18, P8.9
TS+09: M4a1.23, P9.9
TS+10: M4b1.24, P10.9
TS+11: M4a1.27, P11.9
TS+12: M4b1.28, P12.9
TS+13: M4a1.31, P13.9
TS+14: M4b1.32, P14.9
TS+15: M4a1.35, P15.9
TS+16: M4b1.36, P16.9
TS-01: M4a1.3, P1.10, RP7.9
TS-02: M4b1.4, P2.10, RP8.9
TS-03: M4a1.7, P3.10, RP7.8
TS-04: M4b1.8, P4.10, RP8.8
TS-05: M4a1.11, P5.10, RP7.7
TS-06: M4b1.12, P6.10, RP8.7
TS-07: M4a1.15, P7.10, RP7.6
TS-08: M4b1.16, P8.10, RP8.6
TS-09: M4a1.21, P9.10, RP7.5
TS-10: M4b1.22, P10.10, RP8.5
TS-11: M4a1.25, P11.10, RP7.4
TS-12: M4b1.26, P12.10, RP8.4
TS-13: M4a1.29, P13.10, RP7.3
TS-14: M4b1.30, P14.10, RP8.3
TS-15: M4a1.33, P15.10, RP7.2
TS-16: M4b1.34, P16.10, RP8.2
UC0_A0: M2b1.42, U1.16
UC0_A1: M1b1.42, U1.14
UC0_A2: J4.3, U1.12, U2.12, U3.12, U4.12
UC0_A3: J4.1, U1.10, U2.10, U3.10, U4.10
UC0_D2: M1a1.39, U1.9
UC0_D3: M1a1.41, U1.11
UC0_D4: M1a1.43, U1.13
UC0_D5: M1a1.45, U1.15
UC0_D6: M1a1.47, U1.17
UC0_D7: M2a1.39, U1.19
UC0_D8: M2a1.41, U1.21
UC0_D9: M2a1.43, U1.23
UC0_D10: M2a1.45, U1.24
UC0_D11: M2a1.47, U1.22
UC0_D12: M9a1.7, U1.20
UC0_D13: J4.5, U1.18, U2.18, U3.18, U4.18
UC0_NRST: C15.1, U1.5
UC0_R: R4.1, R5.2, U1.6
UC0_RX: M9a1.5, U1.3
UC0_TX: M9a1.3, U1.1
UC1_A0: M4b1.42, U2.16
UC1_A1: M3b1.42, U2.14
UC1_D2: M3a1.39, U2.9
UC1_D3: M3a1.41, U2.11
UC1_D4: M3a1.43, U2.13
UC1_D5: M3a1.45, U2.15
UC1_D6: M3a1.47, U2.17
UC1_D7: M4a1.39, U2.19
UC1_D8: M4a1.41, U2.21
UC1_D9: M4a1.43, U2.23
UC1_D10: M4a1.45, U2.24
UC1_D11: M4a1.47, U2.22
UC1_D12: M9a1.13, U2.20
UC1_NRST: C16.1, U2.5
UC1_R: R3.1, R4.2, U2.6
UC1_RX: M9a1.11, U2.3
UC1_TX: M9a1.9, U2.1
UC2_A0: M6b1.42, U3.16
UC2_A1: M5b1.42, U3.14
UC2_D2: M5a1.39, U3.9
UC2_D3: M5a1.41, U3.11
UC2_D4: M5a1.43, U3.13
UC2_D5: M5a1.45, U3.15
UC2_D6: M5a1.47, U3.17
UC2_D7: M6a1.39, U3.19
UC2_D8: M6a1.41, U3.21
UC2_D9: M6a1.43, U3.23
UC2_D10: M6a1.45, U3.24
UC2_D11: M6a1.47, U3.22
UC2_D12: M9b1.8, U3.20
UC2_NRST: C17.1, U3.5
UC2_R: R2.1, R3.2, U3.6
UC2_RX: M9b1.6, U3.3
UC2_TX: M9b1.4, U3.1
UC3_A0: M8b1.42, U4.16
UC3_A1: M7b1.42, U4.14
UC3_D2: M7a1.39, U4.9
UC3_D3: M7a1.41, U4.11
UC3_D4: M7a1.43, U4.13
UC3_D5: M7a1.45, U4.15
UC3_D6: M7a1.47, U4.17
UC3_D7: M8a1.39, U4.19
UC3_D8: M8a1.41, U4.21
UC3_D9: M8a1.43, U4.23
UC3_D10: M8a1.45, U4.24
UC3_D11: M8a1.47, U4.22
UC3_D12: M9b1.14, U4.20
UC3_NRST: C18.1, U4.5
UC3_R: R1.1, R2.2, U4.6
UC3_RX: M9b1.12, U4.3
UC3_TX: M9b1.10, U4.1
Vcc0: R5.1, U1.8

Notes on the sheet:
DNP (ADC/Tachometer)
GSCLK XLAT SCLK SIN SOUT BLANK
DNP (Spare B)
DNP (PWM)
ADC
M_0 M_1 M_2 M_3 x M_OUT
100k ohms
PWM (Heater)
DNP (Tachometer)
Note: The uC in this section is only connected to one socket, so many of its pins are not connected.
PWM (Fan)
PWM
OPIN_1 GND 1 GND OUT_0 3 OPIN_2 +12V 5 GND OUT_2 7 GND +12V 9 OPIN_5 OUT_4 11 GND +12V 13 OPIN_6 OUT_6 15 GND +12V 17 GND GND 19 OPIN_9 OUT_8 21 GND +12V 23 OPIN_10 OUT_10 25 GND +12V 27 OPIN_13 OUT_12 29 GND +12V 31 OPIN_14 OUT_14 33 GND +12V 35 GND GND 37 M_0 GSCLK 39 M_1 XLAT 41 M_2 SCLK 43 M_3 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
RS-485 board socket
DNP (Spare A)
ADC (Termistor)
Temperature (UC1)
Motherboard ID
ADC (PD)
Optical Density (UC2)
Vial Connectors
CONN
SAMD21
PWM (LED)
Fan/Stir (UC0)
D2 D7 D3 D8 D4 D9 D5 D10 D6 D11 A1 A0
Spare (UC3)
10k ohms
Pin 1,2 M8 (Spare A) Pin 3,4 M7 (Spare B) Pin 5,6 M6 (Photodiode) Pin 7,8 M5 (LED) Pin 9,10 M4 (Termistor) Pin 11,12 M3 (Heater) Pin 13,14 M2 (Tachometer) Pin 15,16 M1 (Fan)
POWER
2 GND GND 4 OUT_1 OPIN_4 6 +12V GND 8 OUT_3 OPIN_3 10 +12V GND 12 OUT_5 OPIN_8 14 +12V GND 16 OUT_7 OPIN_7 18 +12V GND 20 GND GND 22 OUT_9 OPIN_12 24 +12V GND 26 OUT_11 OPIN_11 28 +12V GND 30 OUT_13 OPIN_16 32 +12V GND 34 OUT_15 OPIN_15 36 +12V GND 38 GND GND 40 x +3V3 42 BLANK M_OUT 44 x x 46 +5V 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
