ACA-CNPEM/evolver-harware/Motherboard/Projeto/power.kicad_sch

## KiCad design Motherboard/Projeto/power.kicad_sch (2023-04-28)

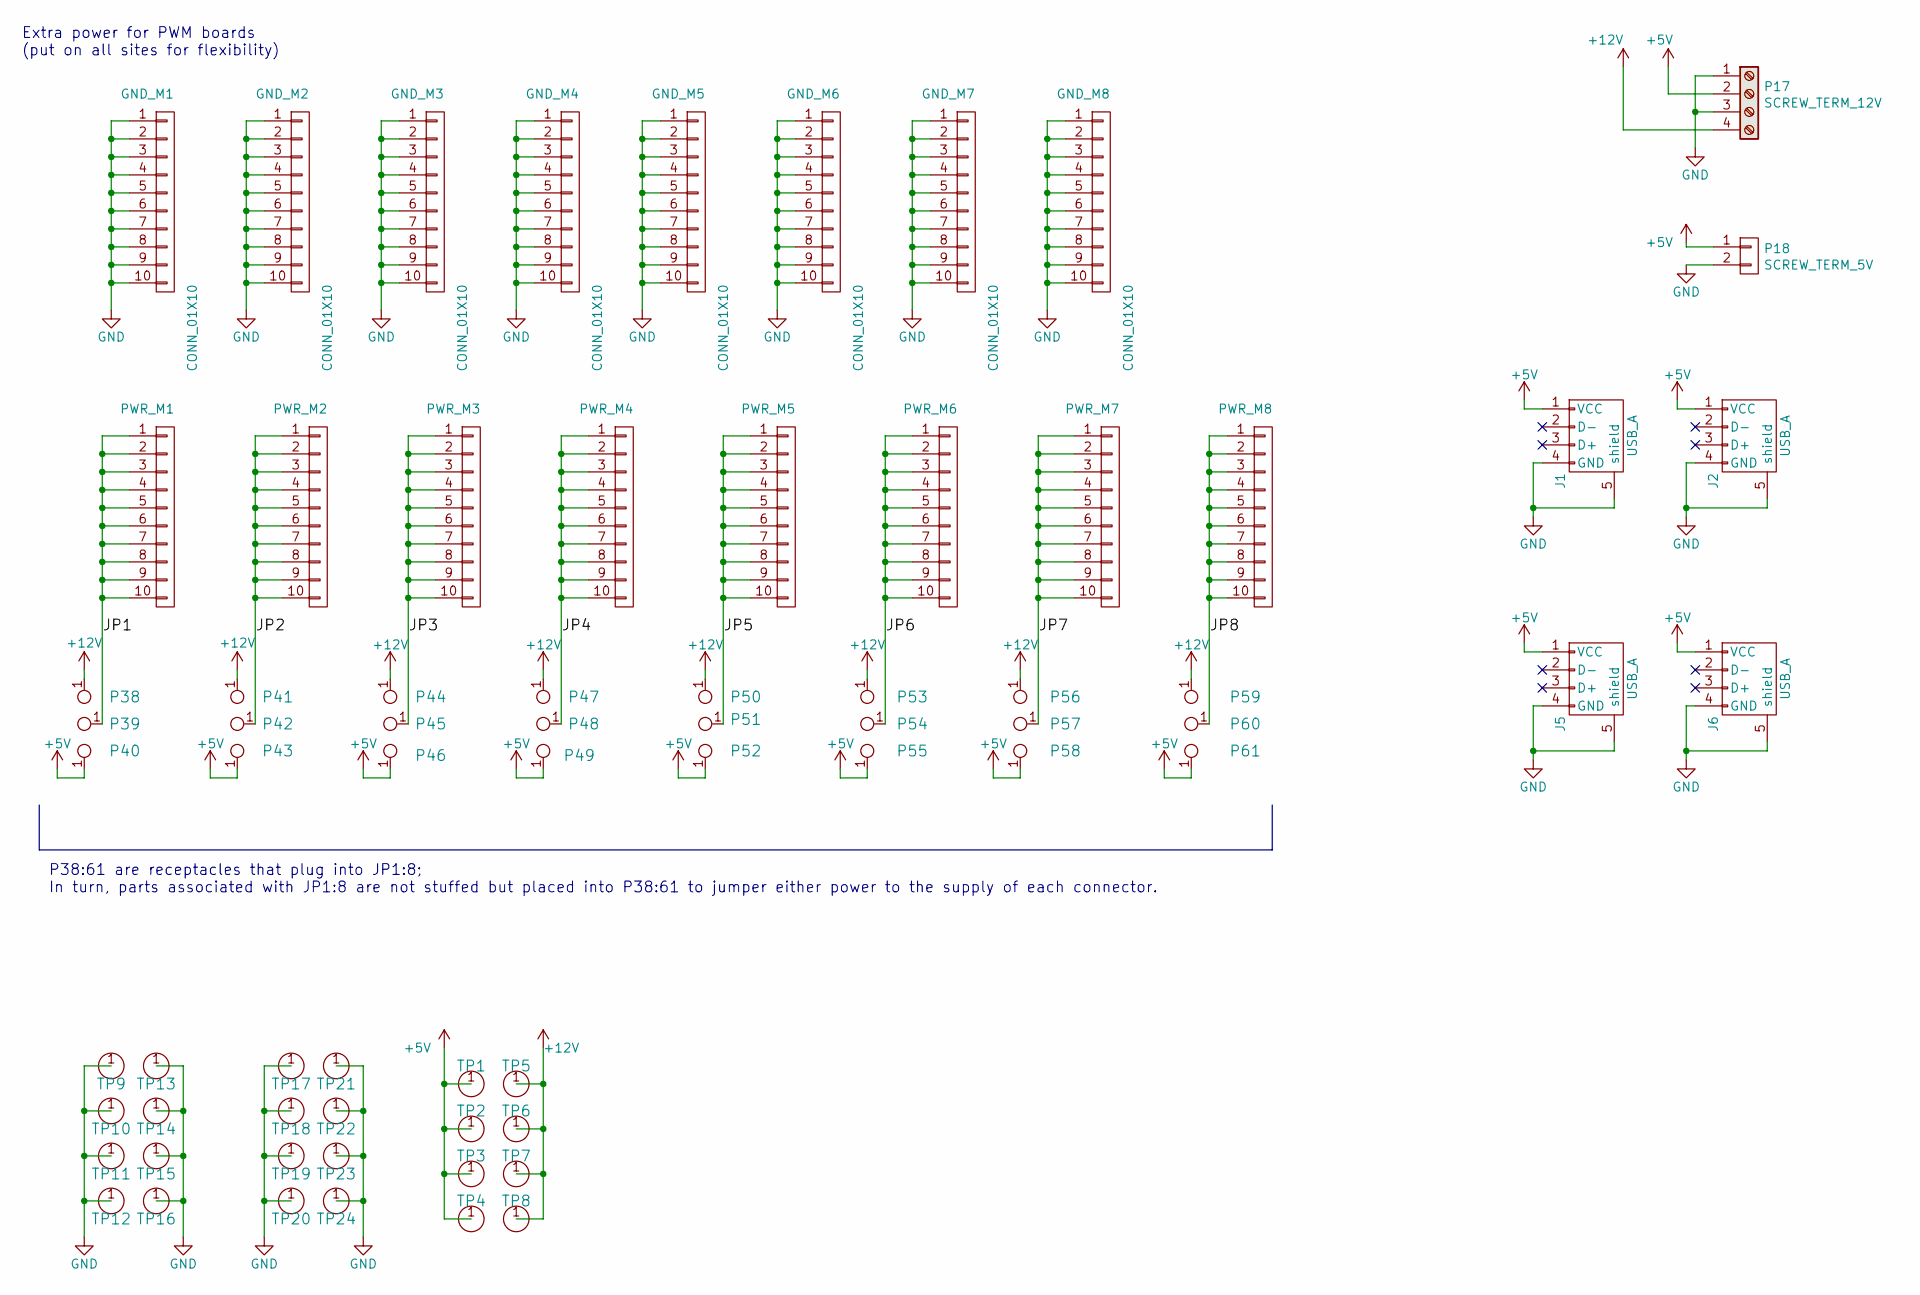
[picture p18: schematic power.kicad_sch]

Parts:
GND_M1, GND_M2, GND_M3, GND_M4, GND_M5, GND_M6, GND_M7, GND_M8: CONN_01X10; 10_pin_10in_BW
J1, J2, J5, J6: USB_A; USB-A
P17: SCREW_TERM_12V; OSTYK51102030
P18: SCREW_TERM_5V; OSTYK51102030
P38, P39, P40, P41, P42, P43, P44, P45, P46, P47, P48, P49, P50, P51, P52, P53, P54, P55, P56, P57, P58, P59, P60, P61: Jumper_Receptacle; Pin_Header_Straight_1x01_Pitch5.08mm
PWR_M1, PWR_M2, PWR_M3, PWR_M4, PWR_M5, PWR_M6, PWR_M7, PWR_M8: CONN_01X10; 10_pin_10in_BW
TP1, TP2, TP3, TP4, TP5, TP6, TP7, TP8, TP9, TP10, TP11, TP12, TP13, TP14, TP15, TP16, TP17, TP18, TP19, TP20, TP21, TP22, TP23, TP24: via_stitch; stitch_via

Connections:
+5V: J1.1 (VCC), J2.1 (VCC), P18.1, P43.1, P46.1, P49.1, P52.1, P55.1, P58.1, P61.1, TP1.1, TP2.1, TP3.1, TP4.1
+12V: P41.1, P44.1, P47.1, P50.1, P53.1, P56.1, P59.1, TP5.1, TP6.1, TP7.1, TP8.1
GND: GND_M1.1, GND_M1.2, GND_M1.3, GND_M1.4, GND_M1.5, GND_M1.6, GND_M1.7, GND_M1.8, GND_M1.9, GND_M1.10, GND_M2.1, GND_M2.2, GND_M2.3, GND_M2.4, GND_M2.5, GND_M2.6, GND_M2.7, GND_M2.8, GND_M2.9, GND_M2.10, GND_M3.1, GND_M3.2, GND_M3.3, GND_M3.4, GND_M3.5, GND_M3.6, GND_M3.7, GND_M3.8, GND_M3.9, GND_M3.10, GND_M4.1, GND_M4.2, GND_M4.3, GND_M4.4, GND_M4.5, GND_M4.6, GND_M4.7, GND_M4.8, GND_M4.9, GND_M4.10, GND_M5.1, GND_M5.2, GND_M5.3, GND_M5.4, GND_M5.5, GND_M5.6, GND_M5.7, GND_M5.8, GND_M5.9, GND_M5.10, GND_M6.1, GND_M6.2, GND_M6.3, GND_M6.4, GND_M6.5, GND_M6.6, GND_M6.7, GND_M6.8, GND_M6.9, GND_M6.10, GND_M7.1, GND_M7.2, GND_M7.3, GND_M7.4, GND_M7.5, GND_M7.6, GND_M7.7, GND_M7.8, GND_M7.9, GND_M7.10, GND_M8.1, GND_M8.2, GND_M8.3, GND_M8.4, GND_M8.5, GND_M8.6, GND_M8.7, GND_M8.8, GND_M8.9, GND_M8.10, J1.4 (GND), J1.5 (shield), J2.4 (GND), J2.5 (shield), P18.2, TP9.1, TP10.1, TP11.1, TP12.1, TP13.1, TP14.1, TP15.1, TP16.1, TP17.1, TP18.1, TP19.1, TP20.1, TP21.1, TP22.1, TP23.1, TP24.1
JP1: P39.1, PWR_M1.1, PWR_M1.2, PWR_M1.3, PWR_M1.4, PWR_M1.5, PWR_M1.6, PWR_M1.7, PWR_M1.8, PWR_M1.9, PWR_M1.10
JP2: P42.1, PWR_M2.1, PWR_M2.2, PWR_M2.3, PWR_M2.4, PWR_M2.5, PWR_M2.6, PWR_M2.7, PWR_M2.8, PWR_M2.9, PWR_M2.10
JP3: P45.1, PWR_M3.1, PWR_M3.2, PWR_M3.3, PWR_M3.4, PWR_M3.5, PWR_M3.6, PWR_M3.7, PWR_M3.8, PWR_M3.9, PWR_M3.10
JP4: P48.1, PWR_M4.1, PWR_M4.2, PWR_M4.3, PWR_M4.4, PWR_M4.5, PWR_M4.6, PWR_M4.7, PWR_M4.8, PWR_M4.9, PWR_M4.10
JP5: P51.1, PWR_M5.1, PWR_M5.2, PWR_M5.3, PWR_M5.4, PWR_M5.5, PWR_M5.6, PWR_M5.7, PWR_M5.8, PWR_M5.9, PWR_M5.10
JP6: P54.1, PWR_M6.1, PWR_M6.2, PWR_M6.3, PWR_M6.4, PWR_M6.5, PWR_M6.6, PWR_M6.7, PWR_M6.8, PWR_M6.9, PWR_M6.10
JP7: P57.1, PWR_M7.1, PWR_M7.2, PWR_M7.3, PWR_M7.4, PWR_M7.5, PWR_M7.6, PWR_M7.7, PWR_M7.8, PWR_M7.9, PWR_M7.10
JP8: P60.1, PWR_M8.1, PWR_M8.2, PWR_M8.3, PWR_M8.4, PWR_M8.5, PWR_M8.6, PWR_M8.7, PWR_M8.8, PWR_M8.9, PWR_M8.10
unnamed: J5.4 (GND), J5.5 (shield)
unnamed: J6.4 (GND), J6.5 (shield)
unnamed: P17.1, P17.3

Notes on the sheet:
P38:61 are receptacles that plug into JP1:8; In turn, parts associated with JP1:8 are not stuffed but placed into P38:61 to jumper either power to the supply of each connector.
Extra power for PWM boards (put on all sites for flexibility)
