ACA-CNPEM/evolver-harware/(commit log)

2023-03-13 gerber files and their pdfs used to make the pcbs added to repo
2023-03-14 pdfs updated and .kicad_pcb files added to repo
    [ADC.kicad_pcb, Auxiliary.kicad_pcb, CMB.kicad_pcb, PWM.kicad_pcb, PiHAT.kicad_pcb, RS485.kicad_pcb]
2023-03-14 schematics added to repo
2023-03-21 hardware files updated and organized in folders per board
    [ADC-B_Cu.gbl, ADC-B_Mask.gbs, ADC-B_SilkS.gbo, ADC-Dwgs_User.gbr, ADC-Edge_Cuts.gm1, ADC-F_Cu.gtl, ADC-F_Mask.gts, ADC-F_Paste.gtp]
2023-04-28 RS485 inverted terminal updated on schematic
    [Motherboard.kicad_sch, power.kicad_sch]
